CDonohoe-Designs/EdgeLink_S3_Cellular/docs/portfolio/EdgeLink_S3_Cellular/images/pcb-copper-bottom.png

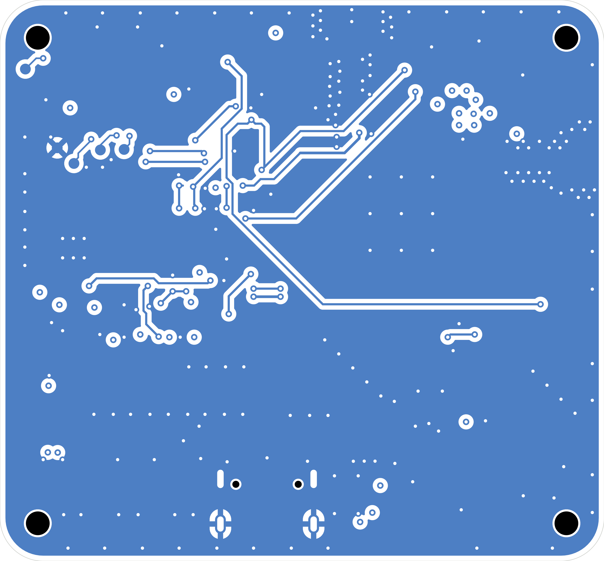
docs/portfolio/EdgeLink_S3_Cellular/images/pcb-copper-bottom.png
