CDonohoe-Designs/EdgeLink_S3_Cellular/docs/portfolio/EdgeLink_S3_Cellular/images/pcb-copper-inner-1.png

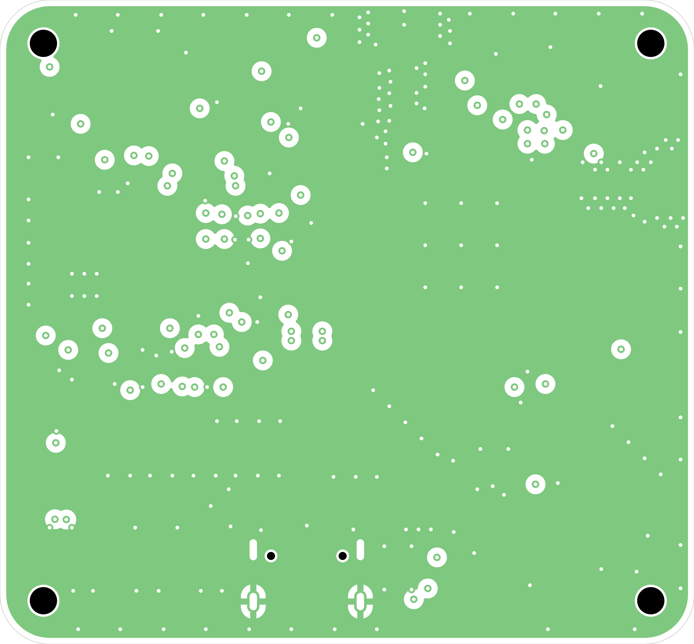
docs/portfolio/EdgeLink_S3_Cellular/images/pcb-copper-inner-1.png
