CDonohoe-Designs/EdgeLink_S3_Cellular/docs/portfolio/EdgeLink_S3_Cellular/images/pcb-stackup-evidence.png

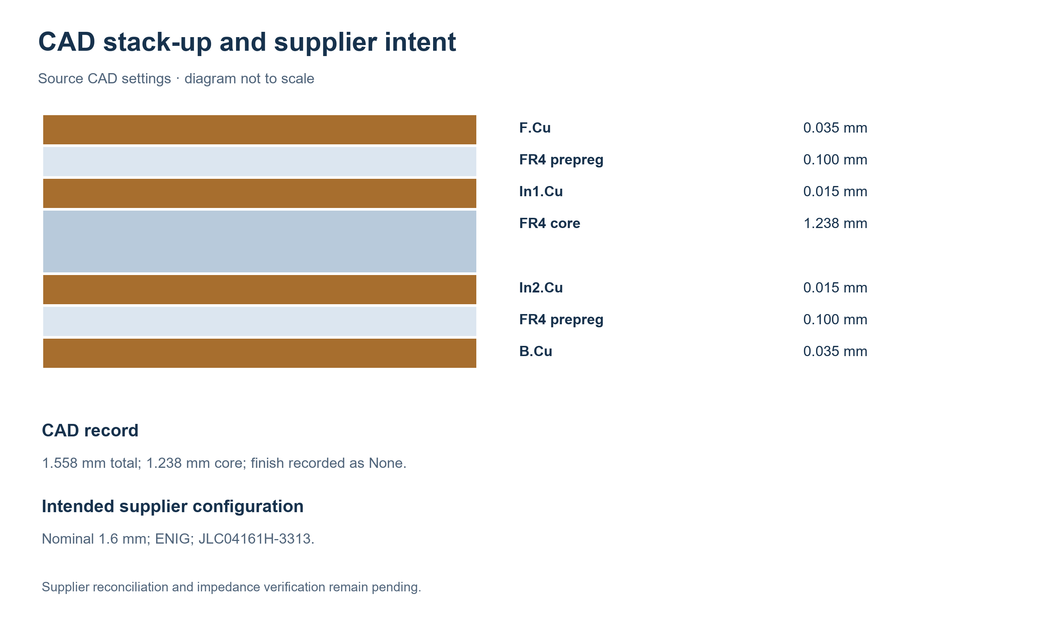
docs/portfolio/EdgeLink_S3_Cellular/images/pcb-stackup-evidence.png
