CDonohoe-Designs/EdgeLink_S3_Cellular/docs/portfolio/EdgeLink_S3_Cellular/images/proposed-six-page-layout.png

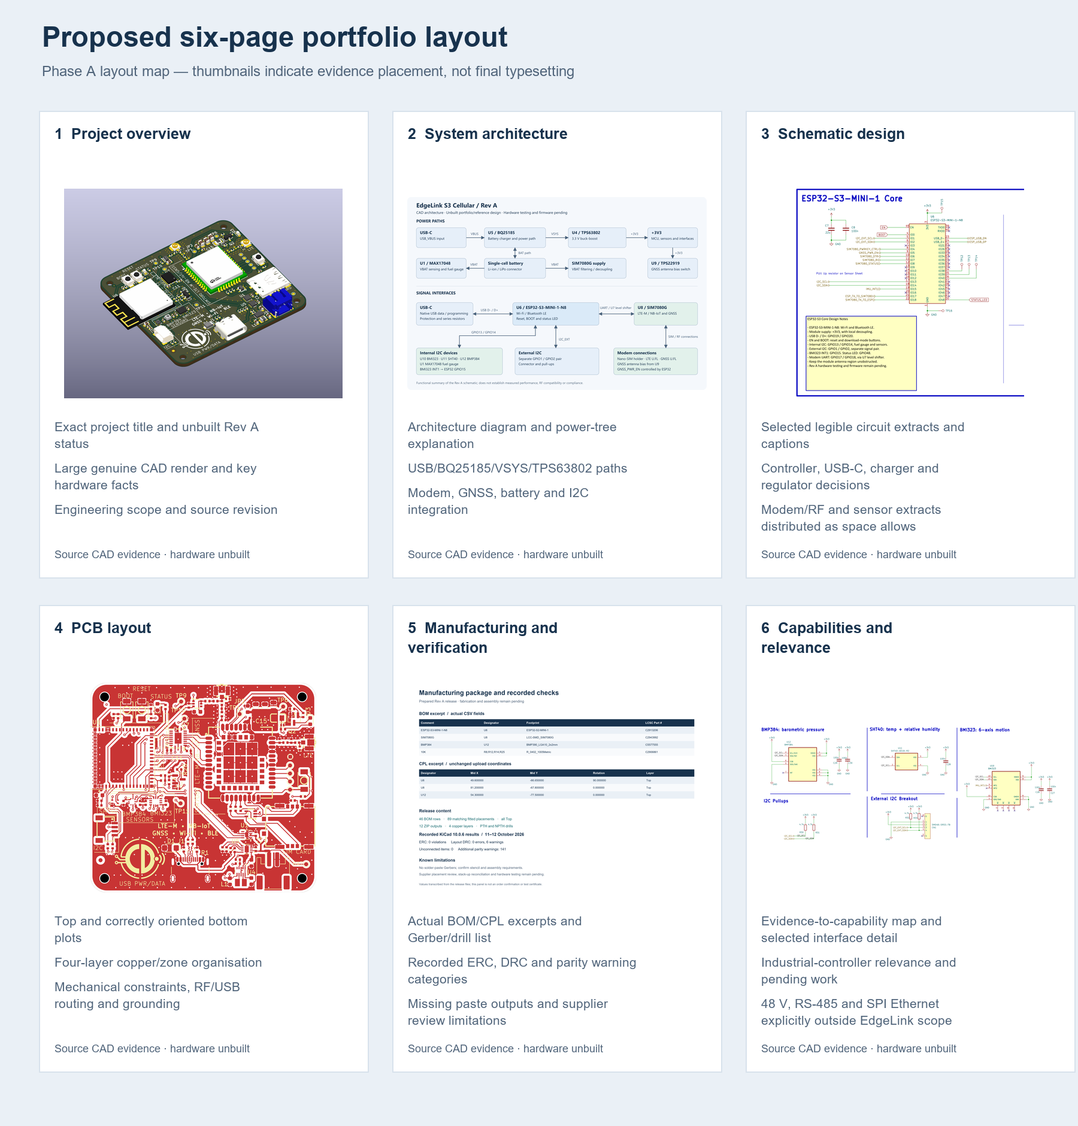
docs/portfolio/EdgeLink_S3_Cellular/images/proposed-six-page-layout.png
