CDonohoe-Designs/EdgeLink_S3_Cellular/docs/portfolio/EdgeLink_S3_Cellular/images/schematic-01_power_usb.png

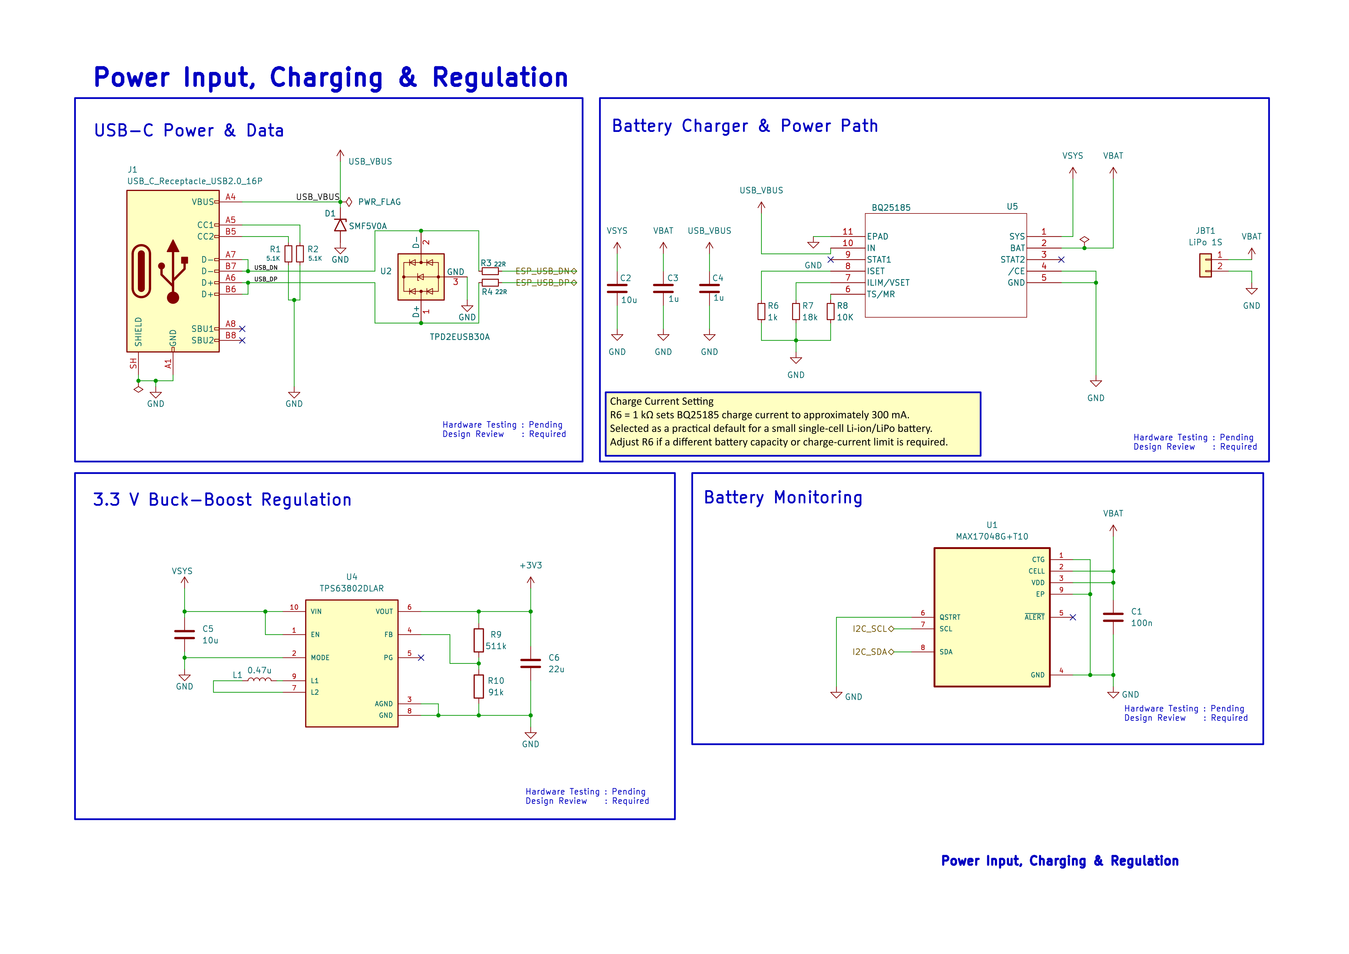
docs/portfolio/EdgeLink_S3_Cellular/images/schematic-01_power_usb.png
