CDonohoe-Designs/EdgeLink_S3_Cellular/docs/portfolio/EdgeLink_S3_Cellular/images/schematic-03_sim7080g_cellular_gnss.png

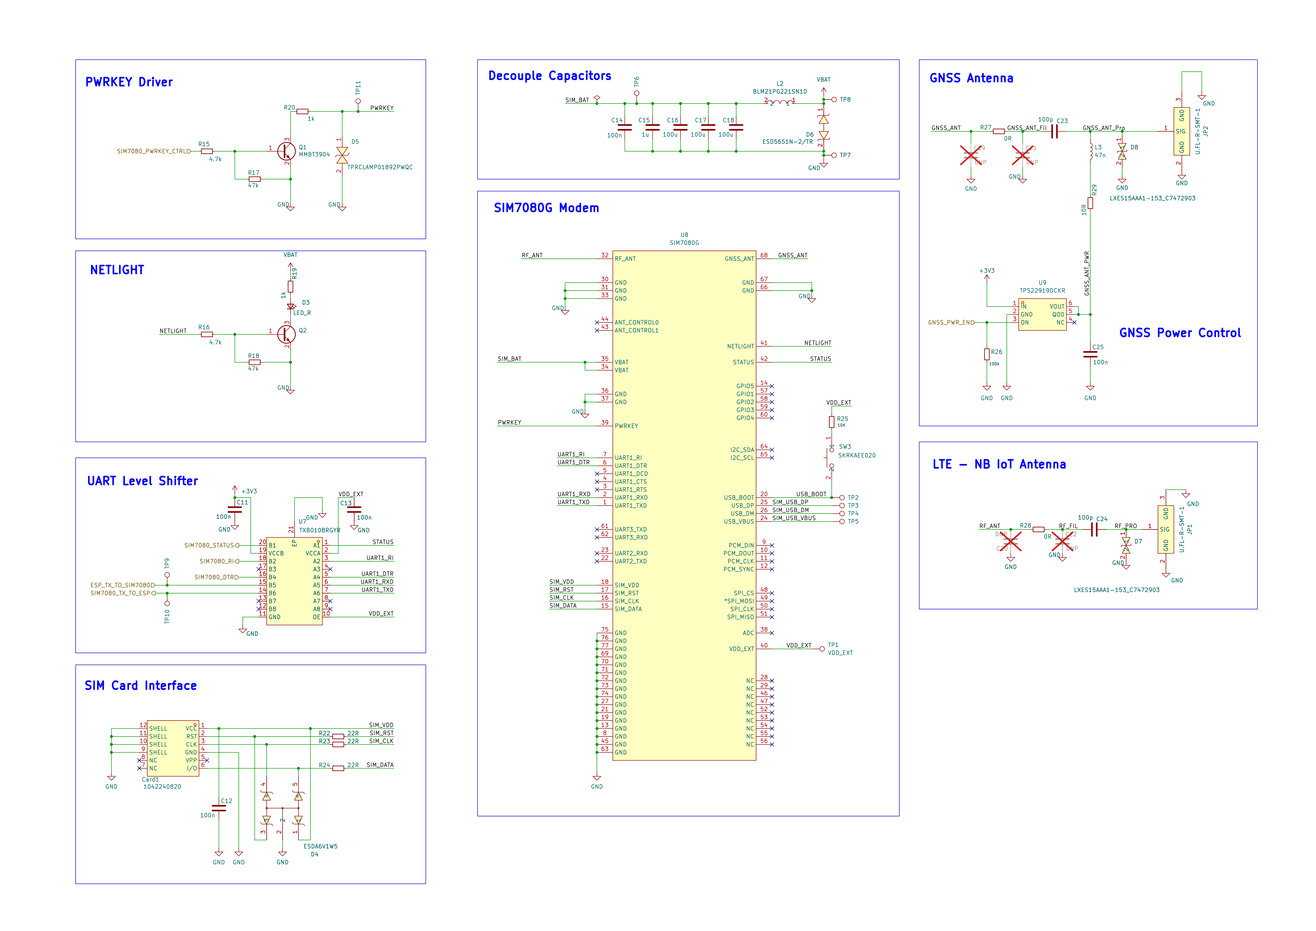
docs/portfolio/EdgeLink_S3_Cellular/images/schematic-03_sim7080g_cellular_gnss.png
