CDonohoe-Designs/EdgeLink_S3_Cellular/docs/portfolio/EdgeLink_S3_Cellular/images/schematic-04_sensors.png

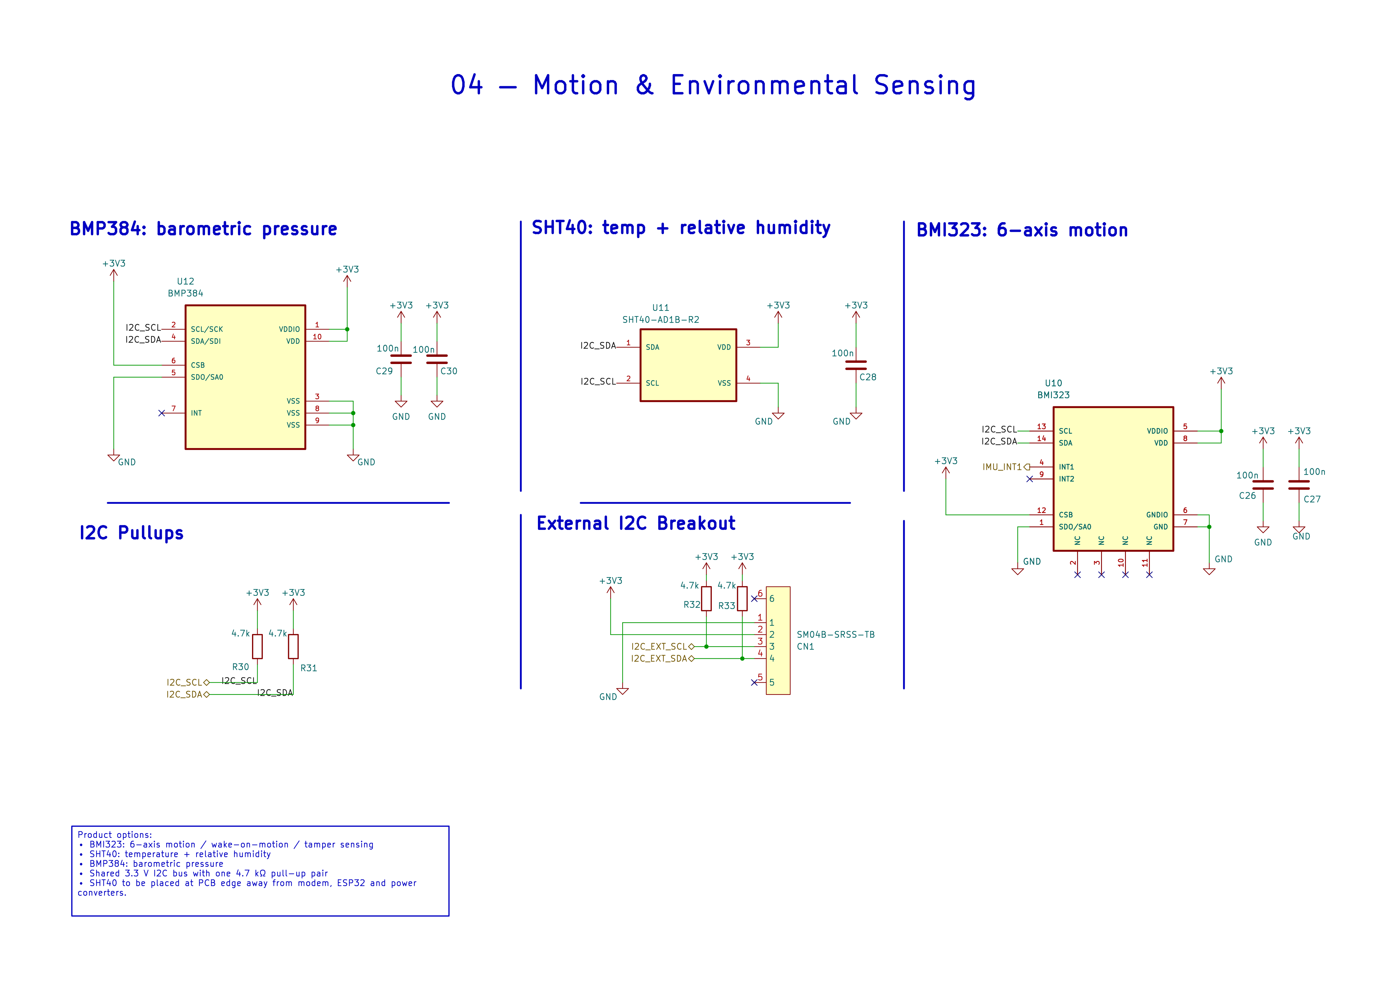
docs/portfolio/EdgeLink_S3_Cellular/images/schematic-04_sensors.png
