CDonohoe-Designs/EdgeLink_S3_Cellular/docs/portfolio/EdgeLink_S3_Cellular/images/schematic-bmi323.png

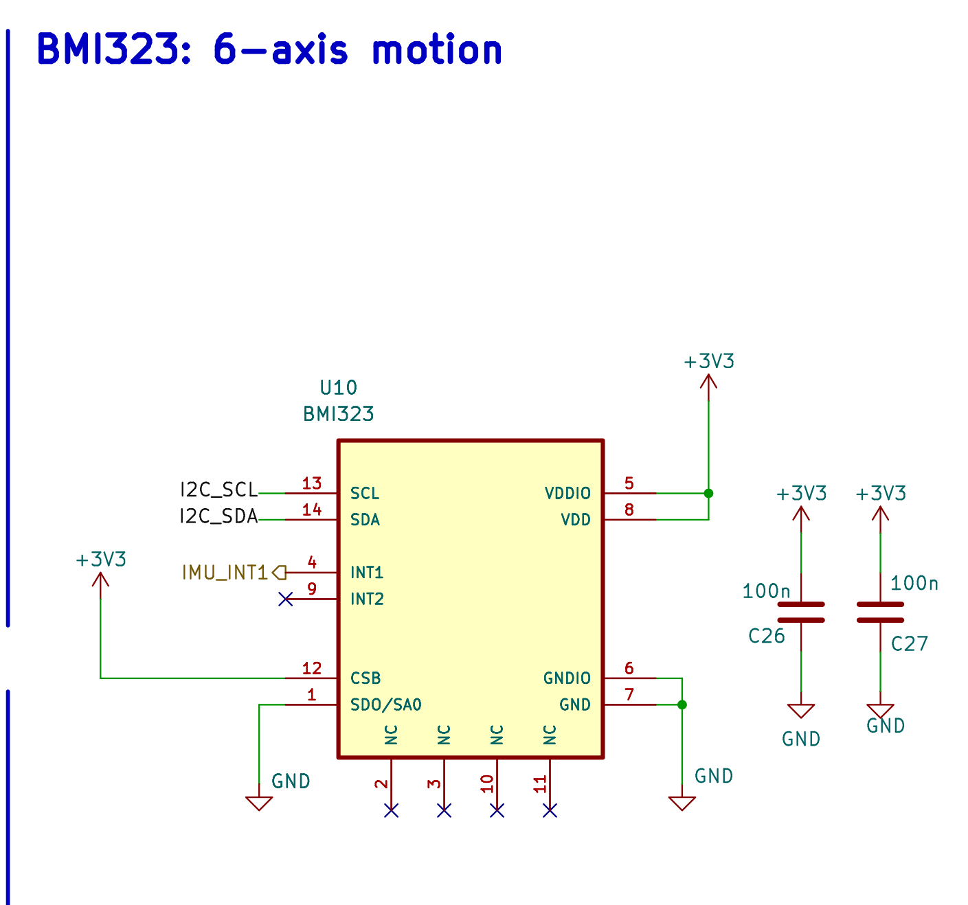
docs/portfolio/EdgeLink_S3_Cellular/images/schematic-bmi323.png
