CDonohoe-Designs/EdgeLink_S3_Cellular/docs/portfolio/EdgeLink_S3_Cellular/images/schematic-controller.png

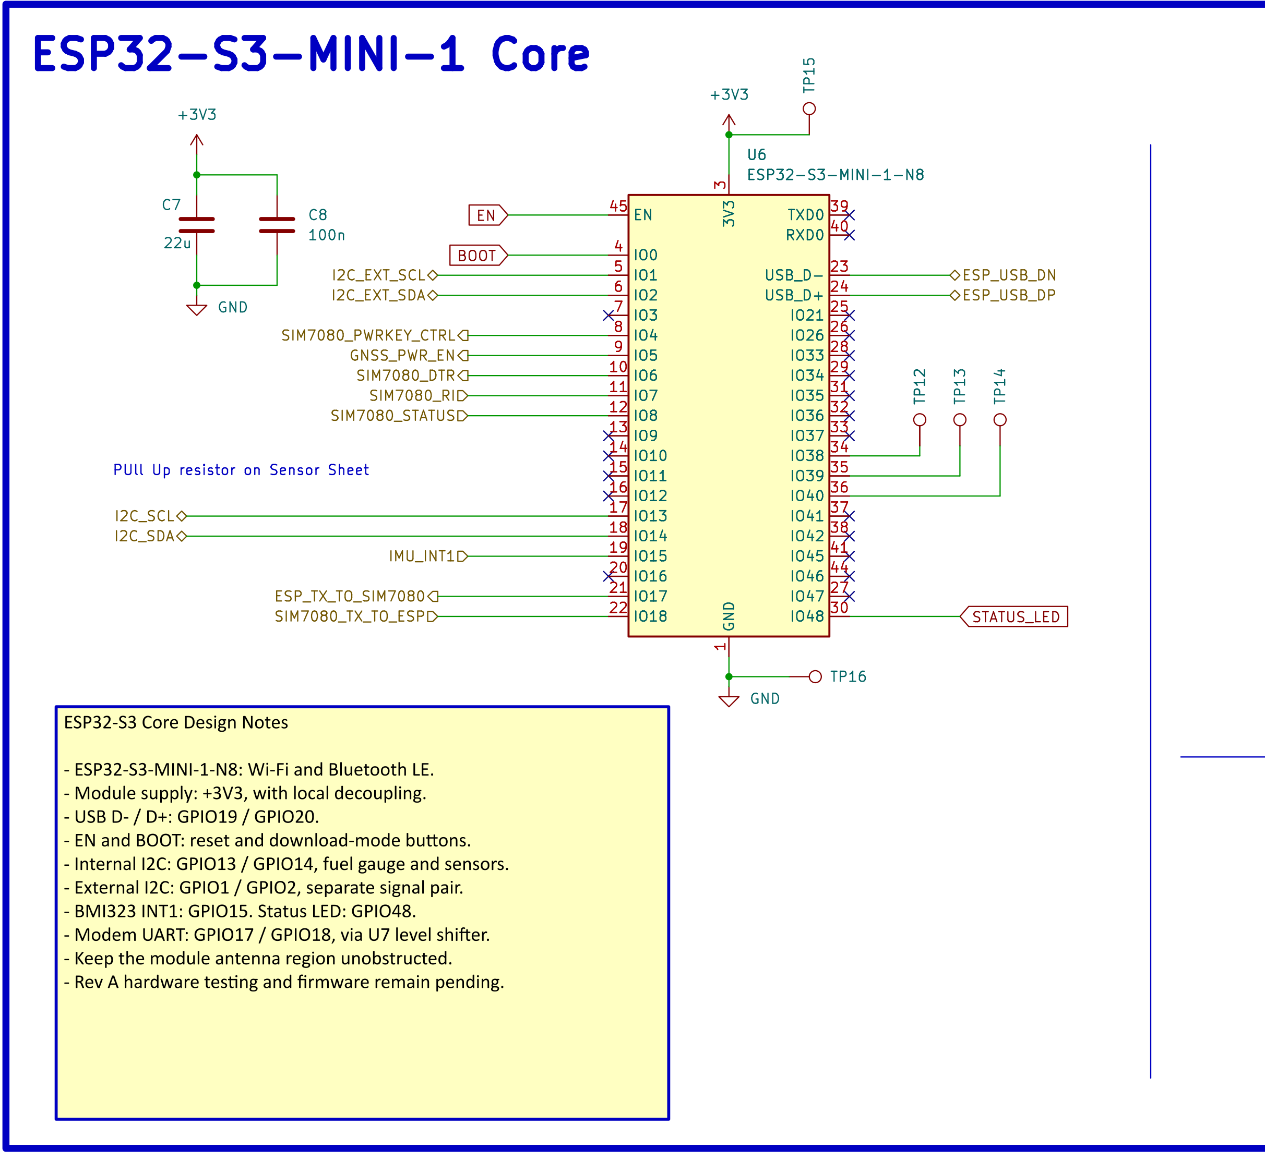
docs/portfolio/EdgeLink_S3_Cellular/images/schematic-controller.png
