CDonohoe-Designs/EdgeLink_S3_Cellular/docs/portfolio/EdgeLink_S3_Cellular/images/schematic-fuel-gauge.png

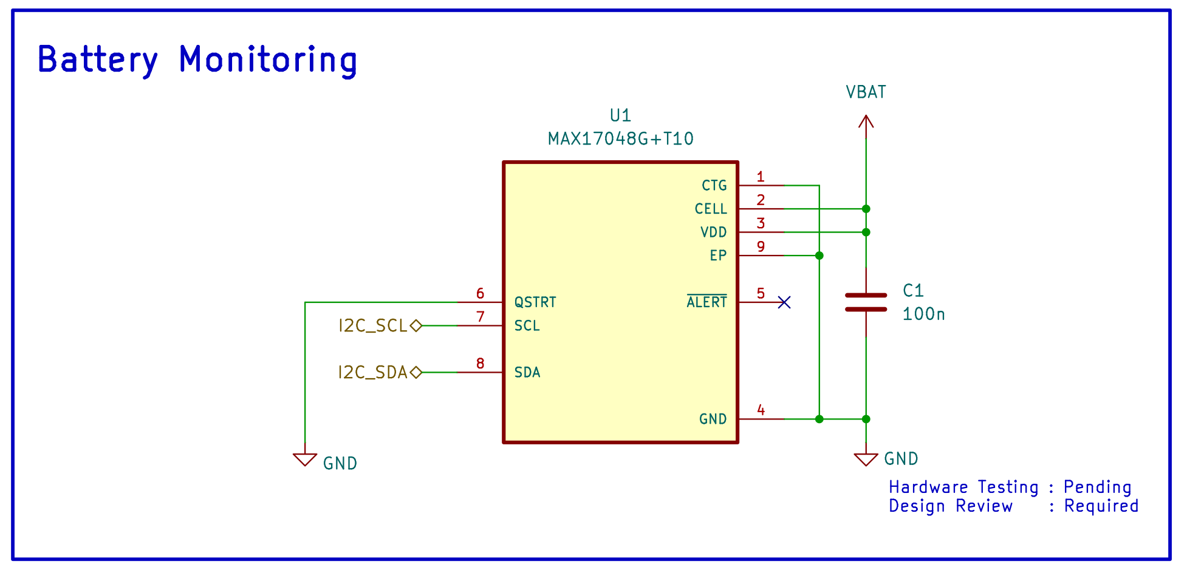
docs/portfolio/EdgeLink_S3_Cellular/images/schematic-fuel-gauge.png
