CDonohoe-Designs/EdgeLink_S3_Cellular/docs/portfolio/EdgeLink_S3_Cellular/images/schematic-gnss-antenna-power.png

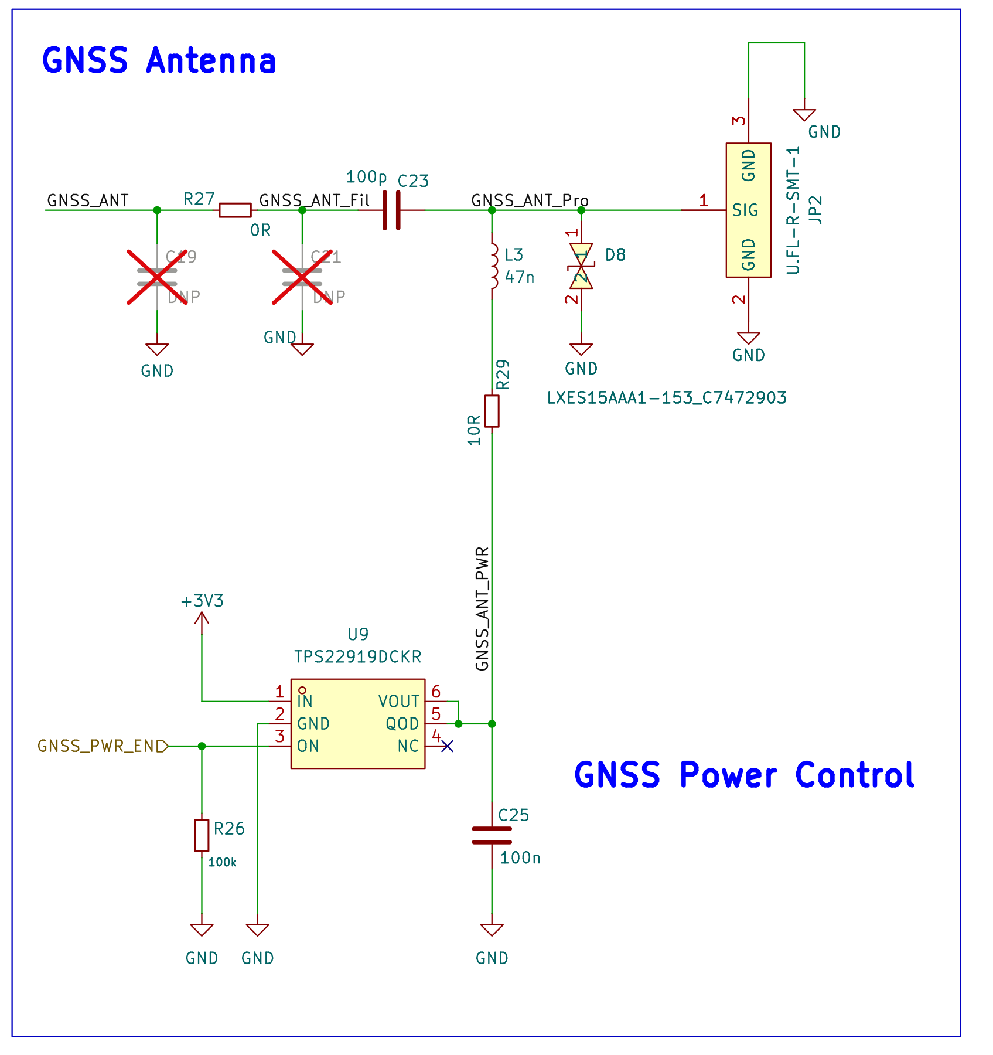
docs/portfolio/EdgeLink_S3_Cellular/images/schematic-gnss-antenna-power.png
