CDonohoe-Designs/EdgeLink_S3_Cellular/docs/portfolio/EdgeLink_S3_Cellular/images/schematic-lte-rf-interface.png

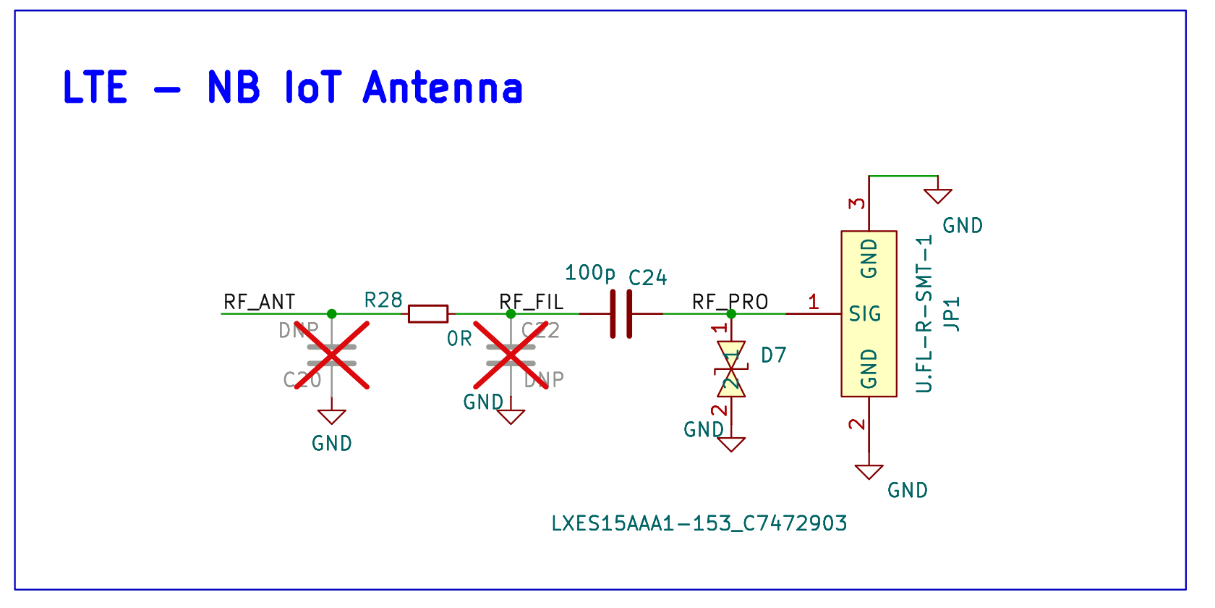
docs/portfolio/EdgeLink_S3_Cellular/images/schematic-lte-rf-interface.png
