CDonohoe-Designs/EdgeLink_S3_Cellular/docs/portfolio/EdgeLink_S3_Cellular/images/schematic-modem-uart-level-shifter.png

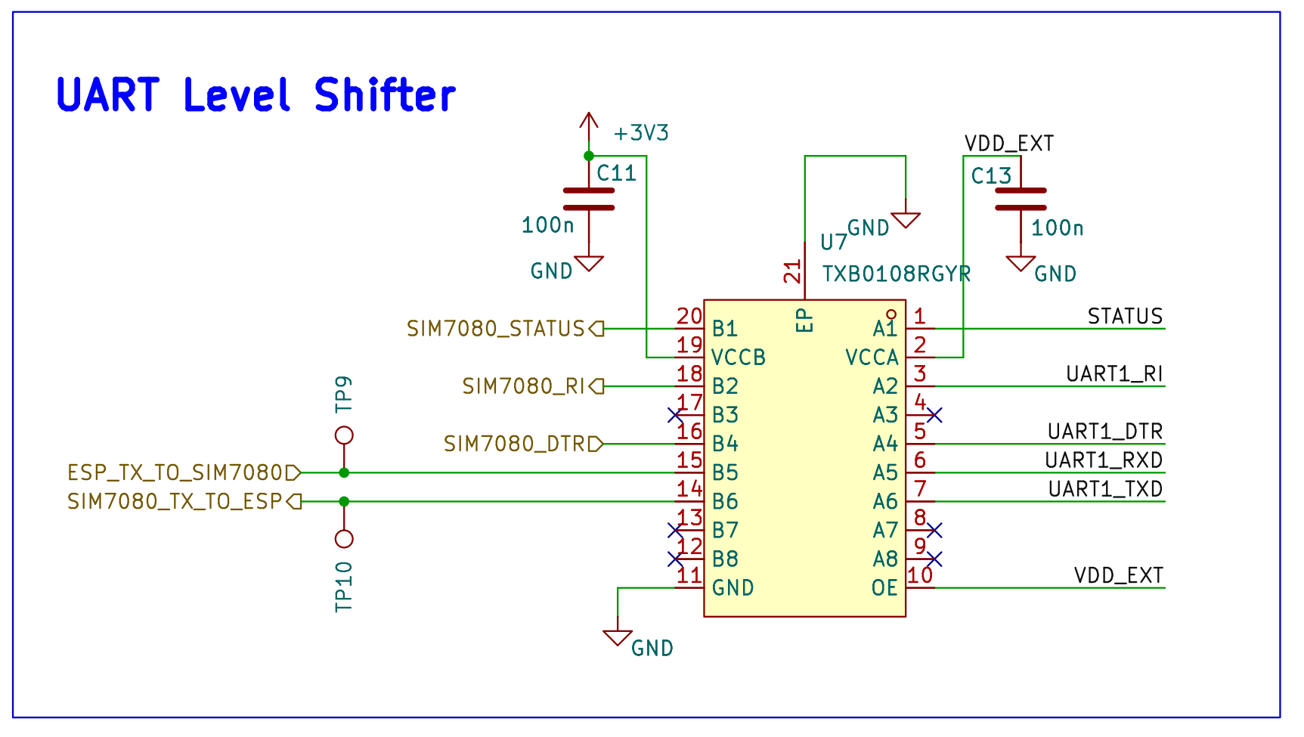
docs/portfolio/EdgeLink_S3_Cellular/images/schematic-modem-uart-level-shifter.png
