CDonohoe-Designs/EdgeLink_S3_Cellular/docs/portfolio/EdgeLink_S3_Cellular/images/schematic-nano-sim.png

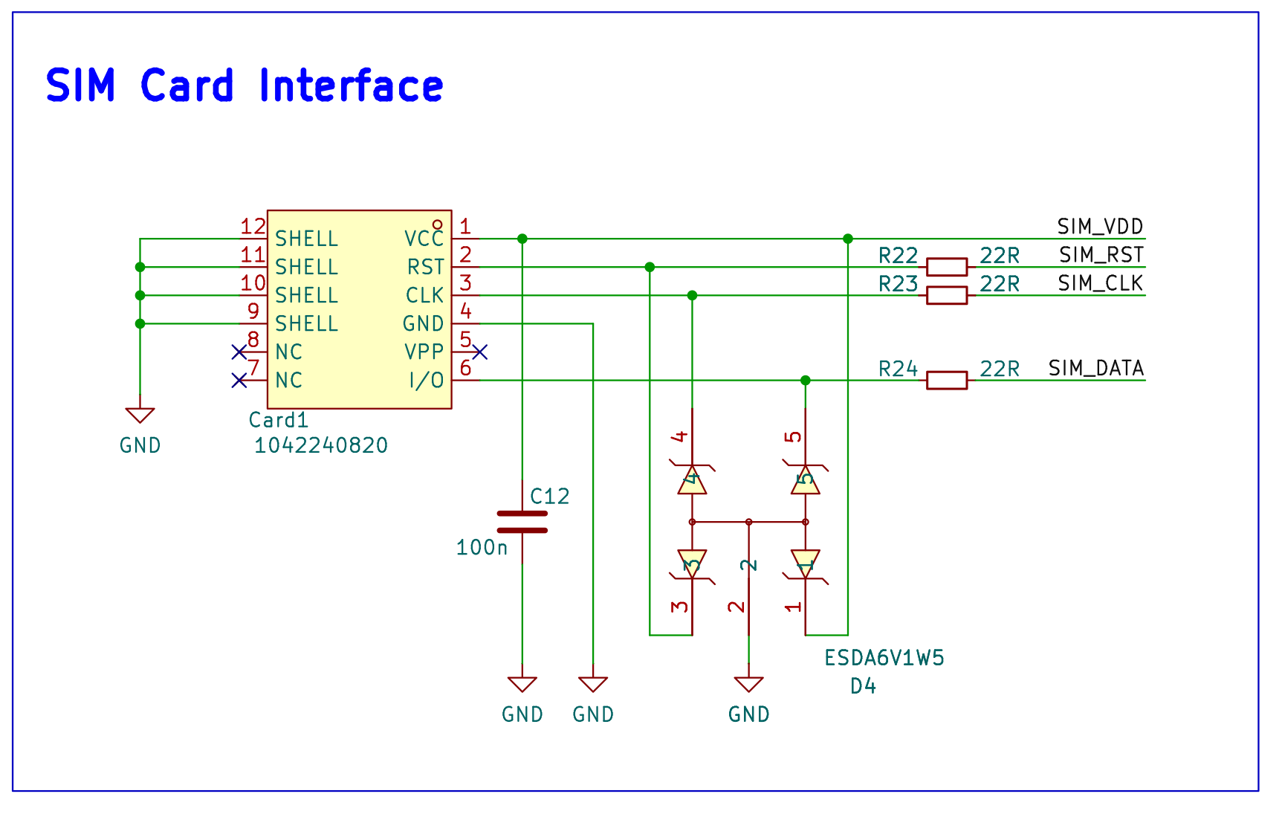
docs/portfolio/EdgeLink_S3_Cellular/images/schematic-nano-sim.png
