CDonohoe-Designs/EdgeLink_S3_Cellular/docs/portfolio/EdgeLink_S3_Cellular/images/schematic-sensors-i2c.png

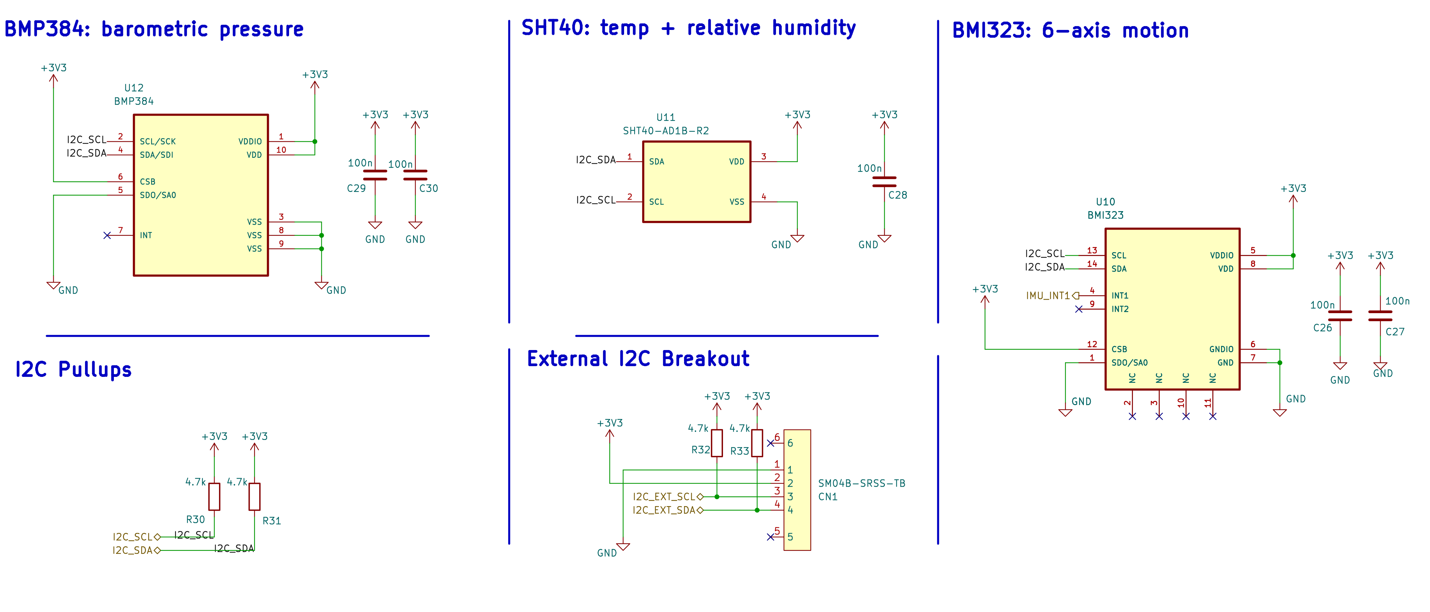
docs/portfolio/EdgeLink_S3_Cellular/images/schematic-sensors-i2c.png
