CDonohoe-Designs/EdgeLink_S3_Cellular/docs/portfolio/EdgeLink_S3_Cellular/images/schematic-sim7080g-interface.png

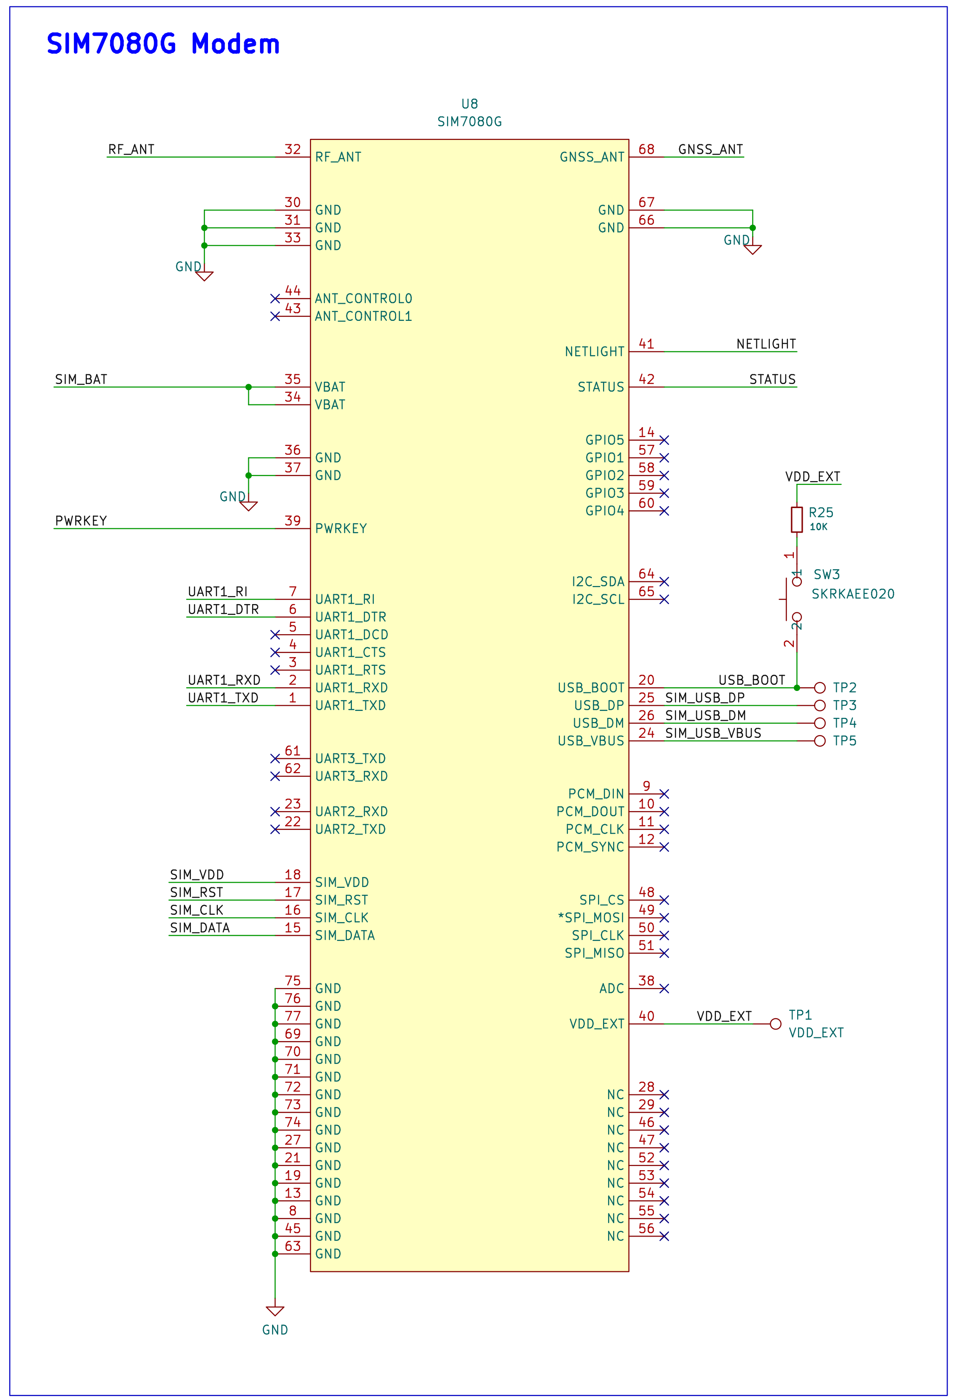
docs/portfolio/EdgeLink_S3_Cellular/images/schematic-sim7080g-interface.png
