CDonohoe-Designs/EdgeLink_S3_Cellular/docs/portfolio/EdgeLink_S3_Cellular/images/schematic-tps63802-regulator.png

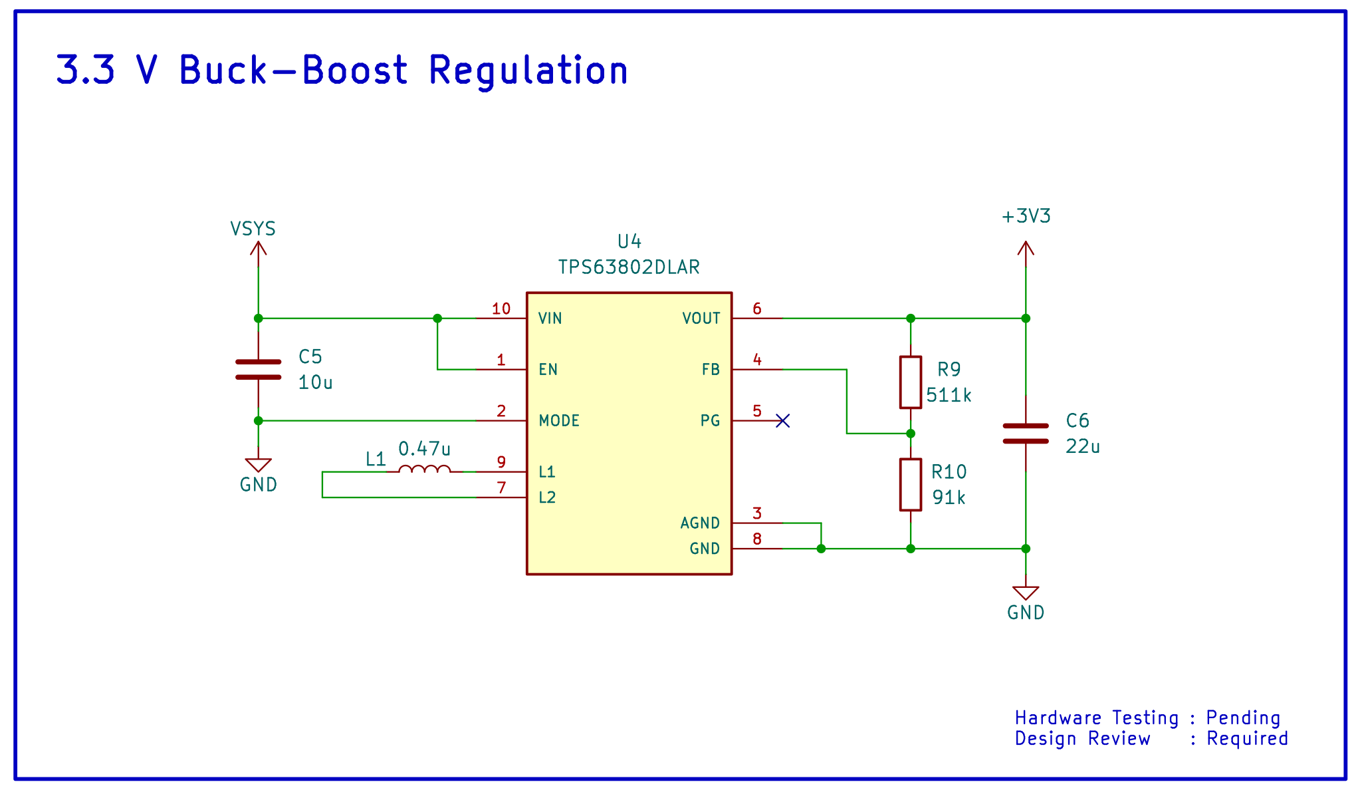
docs/portfolio/EdgeLink_S3_Cellular/images/schematic-tps63802-regulator.png
