CDonohoe-Designs/EdgeLink_S3_Cellular/manufacturing/REV_A/bom/EdgeLink_S3_Cellular_RevA_BOM_JLCPCB.csv

Reference | Qty | Value | Footprint | Manufacturer | MPN | LCSC Part | DNP | Datasheet
D1 | 1 | SMF5V0A | Diode_SMD:D_SMF | VISHAY | SMF5V0A-E3-08 | C1972946 |  | https://www.vishay.com/doc?85881
J1 | 1 | USB_C_Receptacle_USB2.0_16P | Connector_USB:USB_C_Receptacle_GCT_USB4105-xx-A_16P_TopMnt_Horizontal | Global Connector Technology | USB4105-GF-A | C3020560 |  | https://www.usb.org/sites/default/files/documents/usb_type-c.zip
U5 | 1 | BQ25185 | BQ25185:WSON10_DLH_TEX | TI | BQ25185DLHR | C19725033 |  | https://www.ti.com/lit/gpn/bq25185
Q1,Q2 | 2 | MMBT3904 | Package_TO_SOT_SMD:SOT-23 | R+O | MMBT3904 | C7420353 |  | https://www.onsemi.com/pdf/datasheet/pzt3904-d.pdf
D5 | 1 | TPRCLAMP01892PWQC | TPRCLAMP01892PWQC:DFN1006-2L-BI-1 | TECH PUBLIC | TPRCLAMP01892PWQC | C52098254 |  | https://www.lcsc.com/datasheet/C52098254.pdf
D7,D8 | 2 | LXES15AAA1-153_C7472903 | LXES15AAA1-153:DFN1006-2L-BI | TECH PUBLIC | LXES15AAA1-153 | C7472903 |  | https://www.lcsc.com/datasheet/C7472903.pdf
U8 | 1 | SIM7080G | SIM7080G:LCC-SMD_SIM7080G | SIMCom Wireless Solutions | SIM7080G | C2943992 |  | https://www.lcsc.com/datasheet/C2943992.pdf
U9 | 1 | TPS22919DCKR | TPS22919DCKR:SC-70-6_L2.2-W1.3-P0.65-LS2.1-BR | TI | TPS22919DCKR | C2149796 |  | https://www.lcsc.com/datasheet/C2149796.pdf
Card1 | 1 | 1042240820 | 1042240820:SIM-SMD_1042240820 | MOLEX | 1042240820 | C585349 |  | https://www.lcsc.com/datasheet/C585349.pdf
U6 | 1 | ESP32-S3-MINI-1-N8 | RF_Module:ESP32-S2-MINI-1 | ESPRESSIF | ESP32-S3-MINI-1-N8 | C2913206 |  | https://www.espressif.com/sites/default/files/documentation/esp32-s3-mini-1_mini-1u_datasheet_en.pdf
U12 | 1 | BMP384 | Sensor_Footprints:BMP390_LGA10_2x2mm | Bosch Sensortec | BMP384 | C5577555 |  | https://www.bosch-sensortec.com/media/boschsensortec/downloads/datasheets/bst-bmp384-ds003.pdf
U10 | 1 | BMI323 | Package_LGA:Bosch_LGA-14_3x2.5mm_P0.5mm | Bosch | BMI323 | C5368700 |  | https://www.bosch-sensortec.com/media/boschsensortec/downloads/datasheets/bst-bmi323-ds000.PDF
U11 | 1 | SHT40-AD1B-R2 | Sensor_Footprints:SHT4x_DFN4_1.5x1.5mm | Sensirion | SHT40-AD1B-R2 | C2909890 |  | https://sensirion.com/media/documents/33FD6951/6555C40E/Sensirion_Datasheet_SHT4x.pdf
D2,D3 | 2 | LED_R | LED_SMD:LED_0603_1608Metric | LITEON | LTST-C193KRKT-5A | C157741 |  | https://optoelectronics.liteon.com/upload/download/DS22-2005-077/LTST-C193KRKT-5A.PDF
SW1,SW2,SW3 | 3 | SKRKAEE020 | SKRKAEE020:SW-SMD_L3.9-W3.0-P4.45 | ALPSALPINE | SKRKAEE020 | C115357 |  | https://lcsc.com/product-detail/Tactile-Switches_ALPS_SKRKAEE020_3-4-2-1-57N_C115357.html
D6 | 1 | ESD5651N-2/TR | ESD5651N-2:DFN1006-2L-BI-1 | WILLSEMI | ESD5651N-2/TR | C239784 |  | https://lcsc.com/product-detail/Others_Will-Semicon-ESD5651N-2-TR_C239784.html
CN1 | 1 | SM04B-SRSS-TB | SM04B-SRSS-TB:CONN-SMD_4P-P1.00_SM04B-SRSS-TB-LF-SN | JST | SM04B-SRSS-TB(LF)(SN) | C160404 |  | https://lcsc.com/product-detail/Others_JST-Sales-America__JST-Sales-America-SM04B-SRSS-TB-LF-SN_C160404.html
L2 | 1 | BLM21PG221SN1D | BLM21PG221SN1D:L0805 | muRata | BLM21PG221SN1D | C85840 |  | https://lcsc.com/product-detail/Ferrite-Beads-And-Chips_muRata_BLM21PG221SN1D_220R-25-at100MHz-2A_C85840.html
D4 | 1 | ESDA6V1W5 | ESDA6V1W5:SC-70-5_L2.1-W1.3-P0.65-LS2.1-BR | ST | ESDA6V1W5 | C48677 |  | https://lcsc.com/product-detail/Diodes-ESD_STMicroelectronics_ESDA6V1W5_ESDA6V1W5_C48677.html
JP1,JP2 | 2 | U.FL-R-SMT-1 | U:RF-SMD_FRF05002-JSS103M | HRS | U.FL-R-SMT-1(80) | C88374 |  | https://lcsc.com/product-detail/Connectors_HRS_U-FL-R-SMT-1-80_3310472280-IPE-XBoard-end-IPXConnector-SMD_C88374.html
U7 | 1 | TXB0108RGYR | TXB0108RGYR:VQFN-20_L4.5-W3.5-P0.50-BL-EP | TI | TXB0108RGYR | C194701 |  | https://lcsc.com/product-detail/_Texas-Instruments_TXB0108RGYR_Texas-Instruments-Texas-Instruments-TXB0108RGYR_C194701.html
U2 | 1 | TPD2EUSB30A | Package_TO_SOT_SMD:Texas_DRT-3 | TI | TPD2EUSB30ADRTR | C94934 |  | http://www.ti.com/lit/ds/symlink/tpd2eusb30a.pdf
U4 | 1 | TPS63802DLAR | TPS63802:TPS63802DLAR | TI | TPS63802DLAR | C2845237
U1 | 1 | MAX17048G+T10 | Package_DFN_QFN:TDFN-8-1EP_2x2mm_P0.5mm_EP0.8x1.2mm | MAXIM | MAX17048G+T10 | C2682616
R29 | 1 | 10R | Resistor_SMD:R_0402_1005Metric | FOJAN | FRC0402F10R0TS | C2906862
R27,R28 | 2 | 0R | Resistor_SMD:R_0402_1005Metric | UNI-ROYAL | CQ02WGF0000TCE | C2770621
R26 | 1 | 100k | Resistor_SMD:R_0402_1005Metric | FOJAN | FRC0402F1003TS | C2906859
R17,R18 | 2 | 47k | Resistor_SMD:R_0402_1005Metric | UNI-ROYAL | 0402WGF4702TCE | C25792
R15,R16,R30,R31,R32,R33 | 6 | 4.7k | Resistor_SMD:R_0402_1005Metric | UNI-ROYAL | 0402WGF4701TCE | C25900
R10 | 1 | 91k | Resistor_SMD:R_0402_1005Metric | FOJAN | FRC0402F9102TS | C2909393
R9 | 1 | 511k | Resistor_SMD:R_0402_1005Metric | FOJAN | FRC0402F5113TS | C5126239
R8,R12,R14,R25 | 4 | 10K | Resistor_SMD:R_0402_1005Metric | FOJAN | FRC0402F1002TS | C2906861
R7 | 1 | 18k | Resistor_SMD:R_0402_1005Metric | FOJAN | FRC0402F1802TS | C2909327
R6,R13,R19,R20 | 4 | 1k | Resistor_SMD:R_0402_1005Metric | FOJAN | FRC0402F1001TS | C2906864
R3,R4,R22,R23,R24 | 5 | 22R | Resistor_SMD:R_0402_1005Metric | FOJAN | FRC0402F22R0TS | C2929994
R1,R2 | 2 | 5.1K | Resistor_SMD:R_0402_1005Metric | FOJAN | FRC0402F5101TS | C2906874
L3 | 1 | 47n | Inductor_SMD:L_0402_1005Metric | Coilcraft | 0402DC-47NXJRW | C3221702
L1 | 1 | 0.47u | DFE201612E-R47M_P2:INDC2016X120N | muRata | DFE201612E-R47M=P2 | C668312
JBT1 | 1 | LiPo 1S | Connector_JST:JST_PH_S2B-PH-SM4-TB_1x02-1MP_P2.00mm_Horizontal | JST | S2B-PH-SM4-TB(LF)(SN) | C295747
C23,C24 | 2 | 100p | Capacitor_SMD:C_0402_1005Metric | Murata | GCM1555C1H101JA16D | C126492
C16,C17,C18 | 3 | 100u | Capacitor_SMD:C_0805_2012Metric | muRata | GRM21BR60J107ME15L | C141660
C14,C25 | 2 | 100n | Capacitor_SMD:C_0603_1608Metric | YAGEO | CC0603KRX7R9BB104 | C14663
C6,C7 | 2 | 22u | Capacitor_SMD:C_0603_1608Metric | Samsung Electro-Mechanics | CL10A226MO7JZNC | C2762594
C3,C4,C15 | 3 | 1u | Capacitor_SMD:C_0402_1005Metric | Samsung Electro-Mechanics | CL05A105KA5NQNC | C52923
C2,C5 | 2 | 10u | Capacitor_SMD:C_0603_1608Metric | Murata Electronics | GRM188R61E106MA73D | C91606
C1,C8,C9,C10,C11,C12,C13,C26,C27,C28,C29,C30 | 12 | 100n | Capacitor_SMD:C_0402_1005Metric | Samsung Electro-Mechanics | CL05B104KB54PNC | C307331
