CDonohoe-Designs/EdgeLink_S3_Cellular/hardware/kicad/EdgeLink_S3_Cellular_RevA/3D_Models/JST/JST-S2B-PH-SM4-TB.STEP

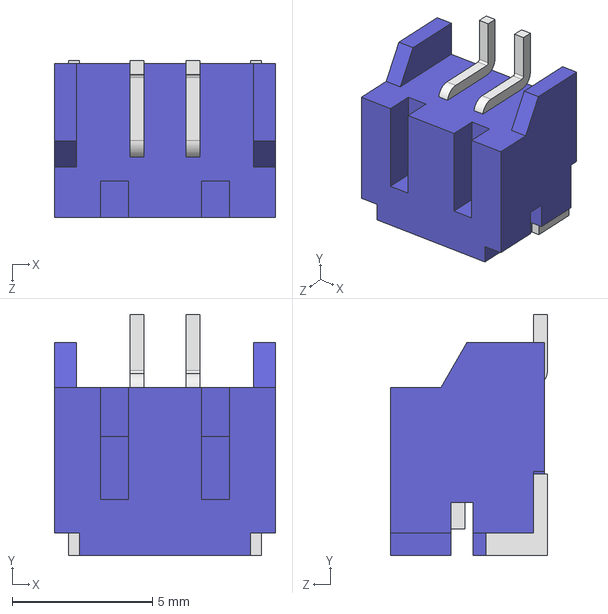
[picture p41: CAD file, 2026-10-12]
hardware/kicad/EdgeLink_S3_Cellular_RevA/3D_Models/JST/JST-S2B-PH-SM4-TB.STEP
7.90 x 8.60 x 5.60 mm
