CDonohoe-Designs/EdgeLink_S3_Cellular/docs/portfolio/EdgeLink_S3_Cellular/images/manufacturing-and-verification-evidence.png

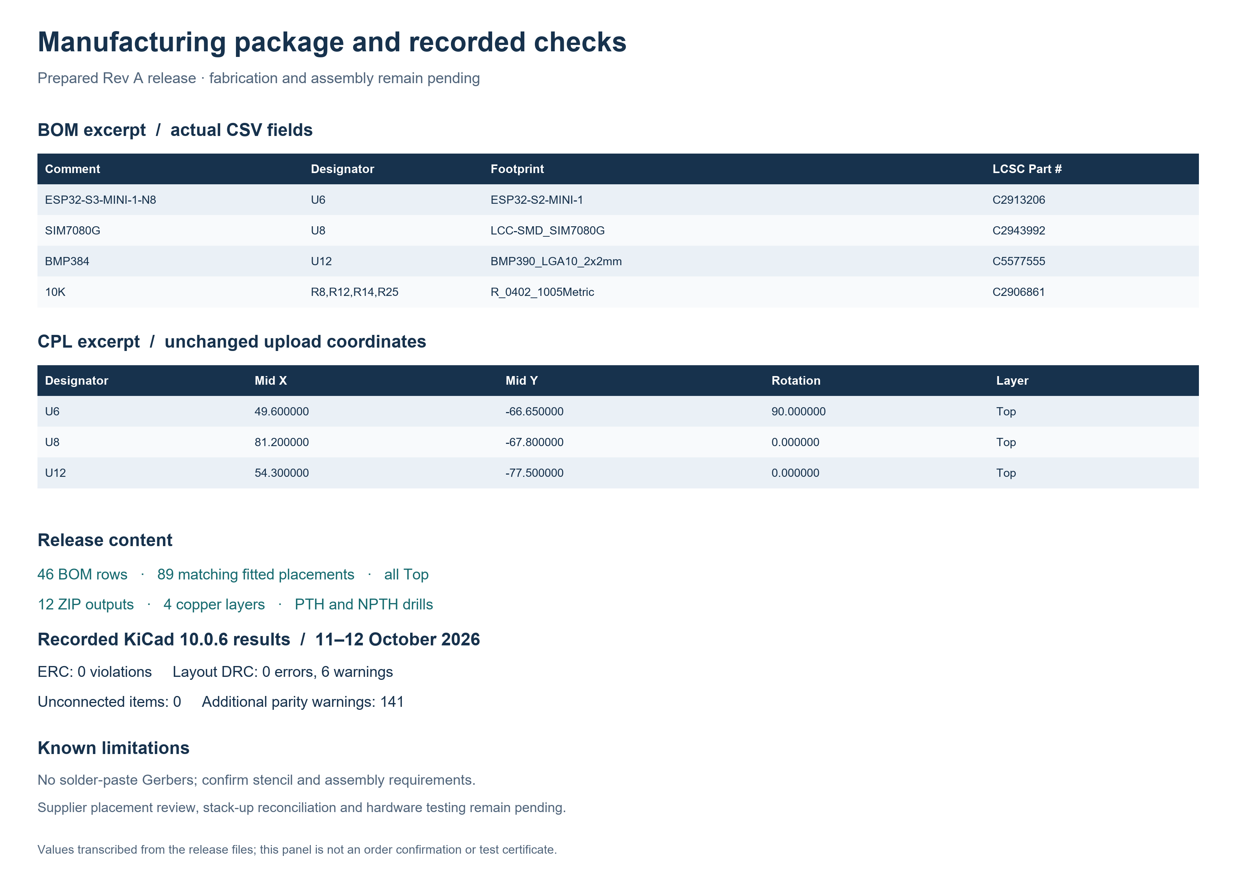
docs/portfolio/EdgeLink_S3_Cellular/images/manufacturing-and-verification-evidence.png
