CDonohoe-Designs/EdgeLink_S3_Cellular/docs/schematics/EdgeLink_S3_Cellular_RevA_Schematic.pdf

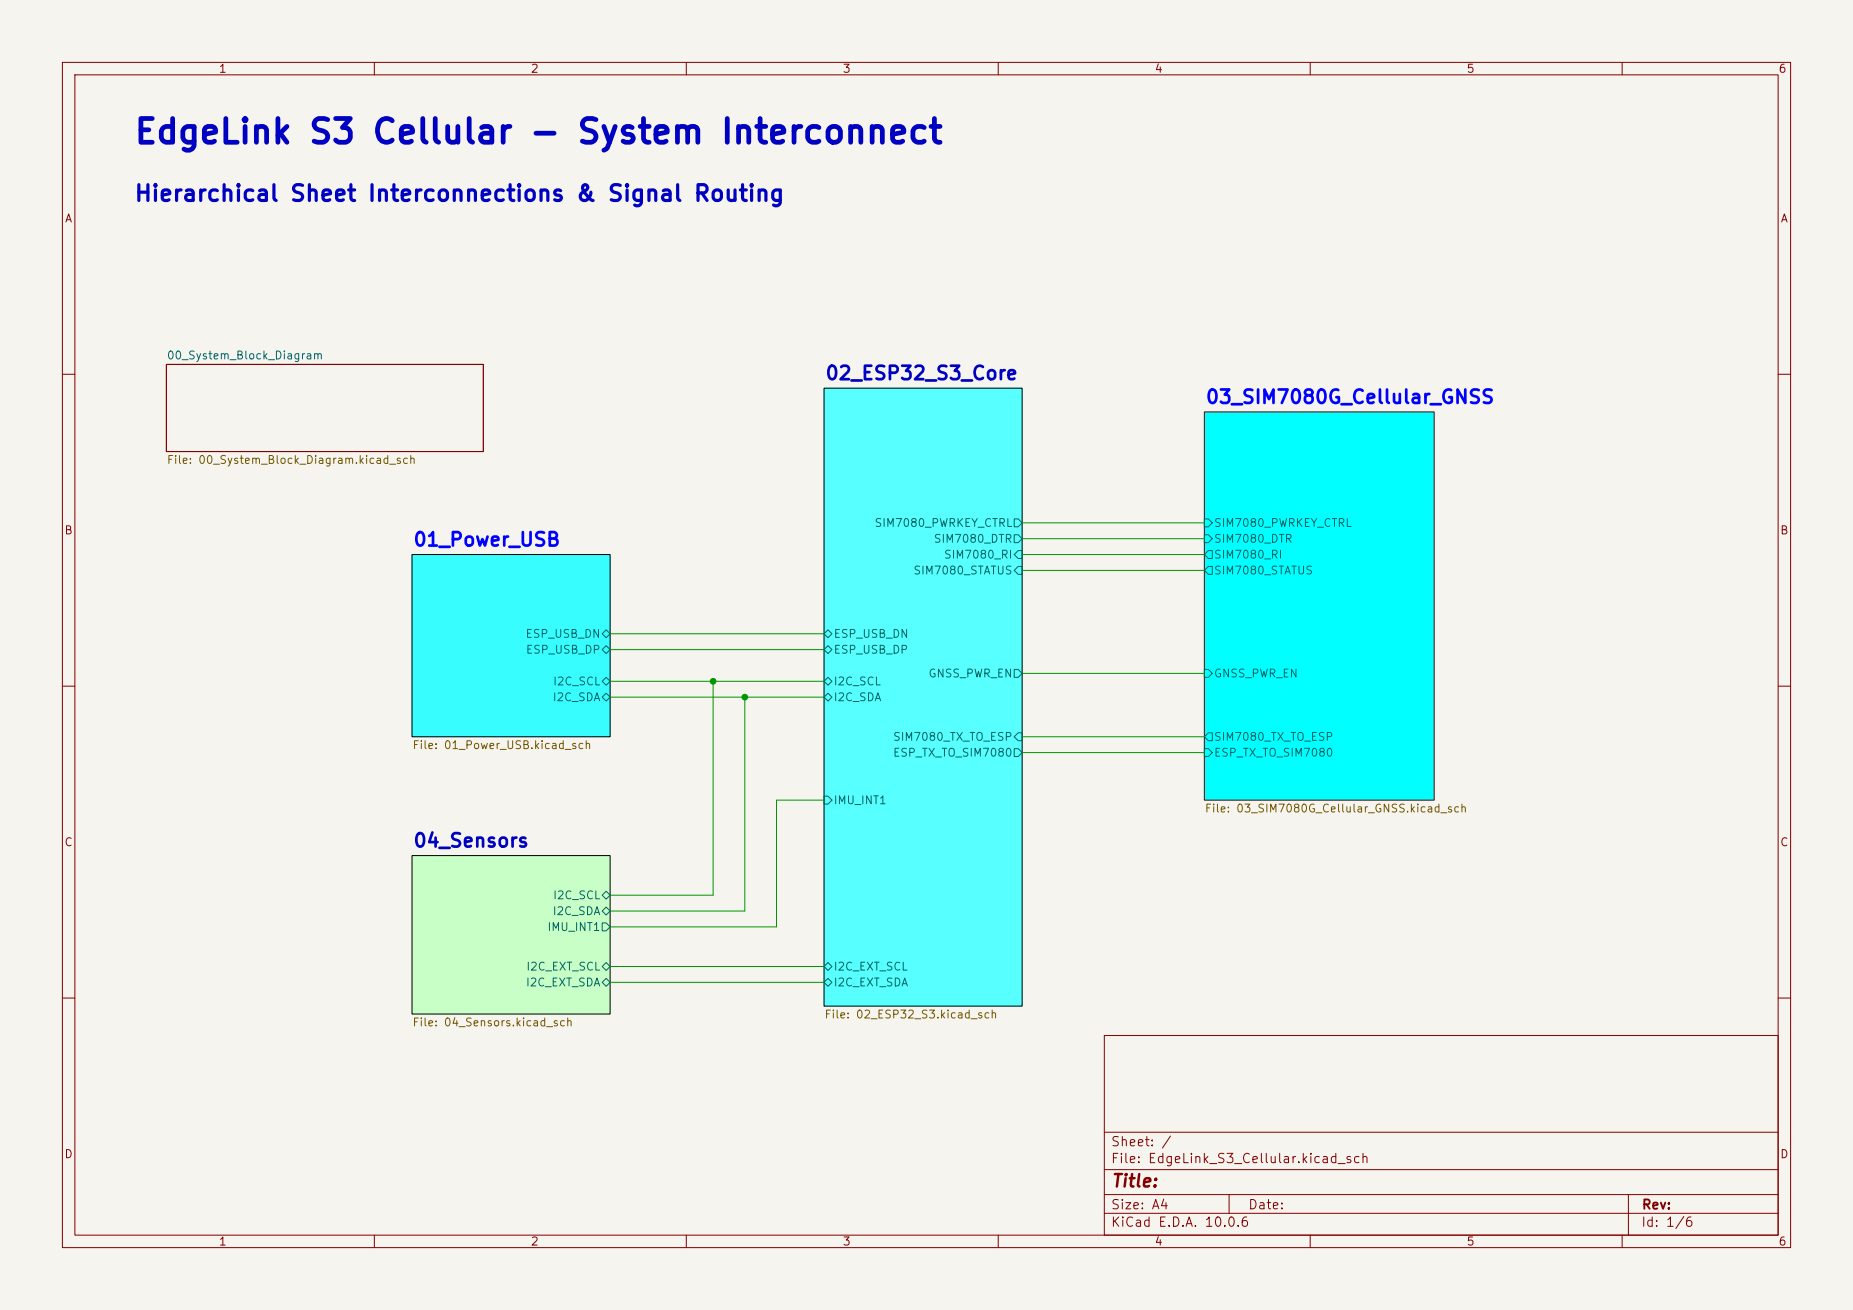
[picture p43: page 1]

EdgeLink S3 Cellular - System Interconnect

Hierarchical Sheet Interconnections & Signal Routing

Size: A4 | Rev:
KiCad E.D.A. 10.0.6 | Id: 1/6

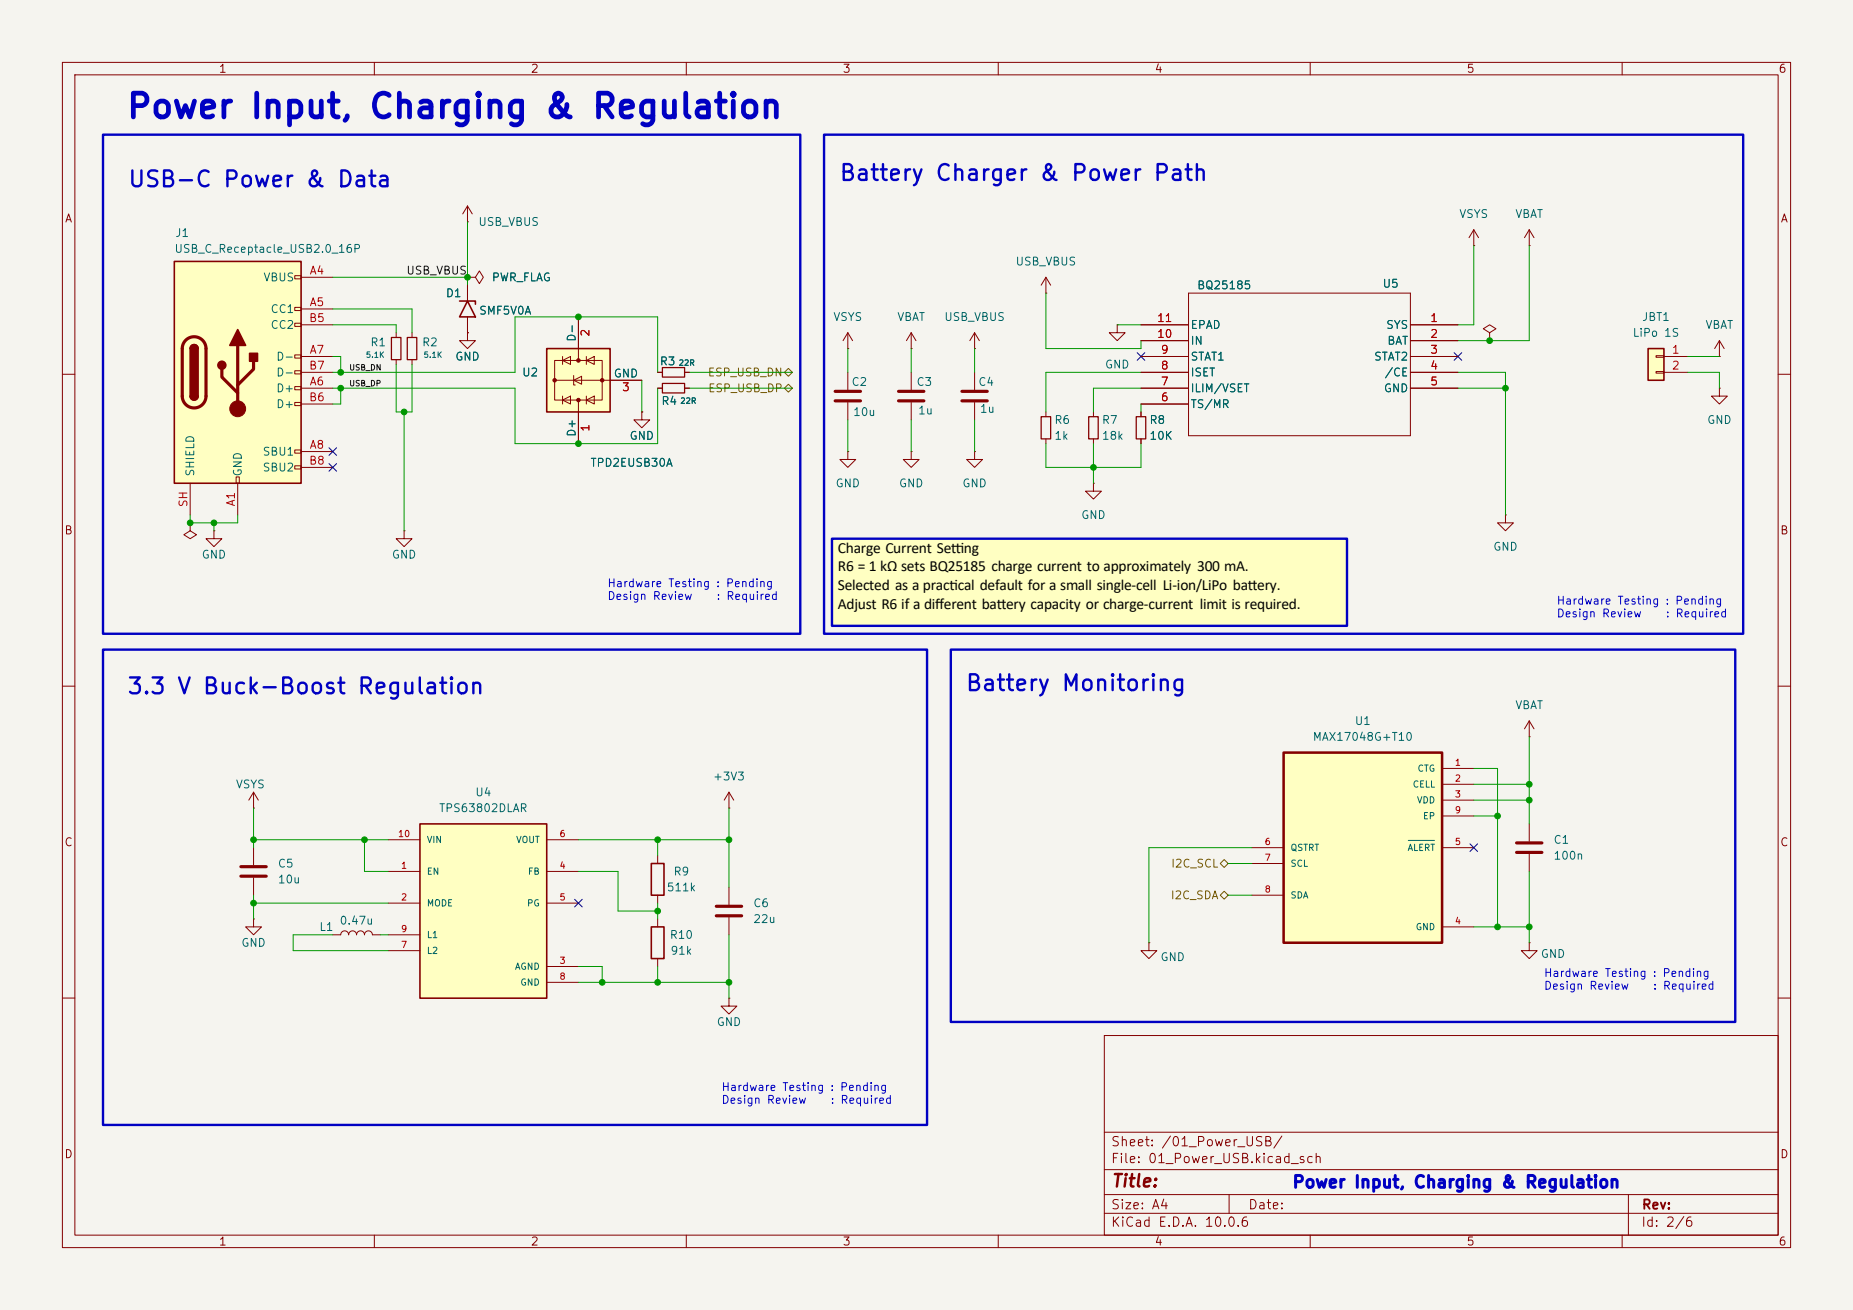
[picture p44: page 2]

Power Input, Charging & Regulation

Battery Charger & Power Path

R6 = 1 kΩ sets BQ25185 charge current to approximately 300 mA.
Selected as a practical default for a small single-cell Li-ion/LiPo battery.
Adjust R6 if a different battery capacity or charge-current limit is required.

D Date:

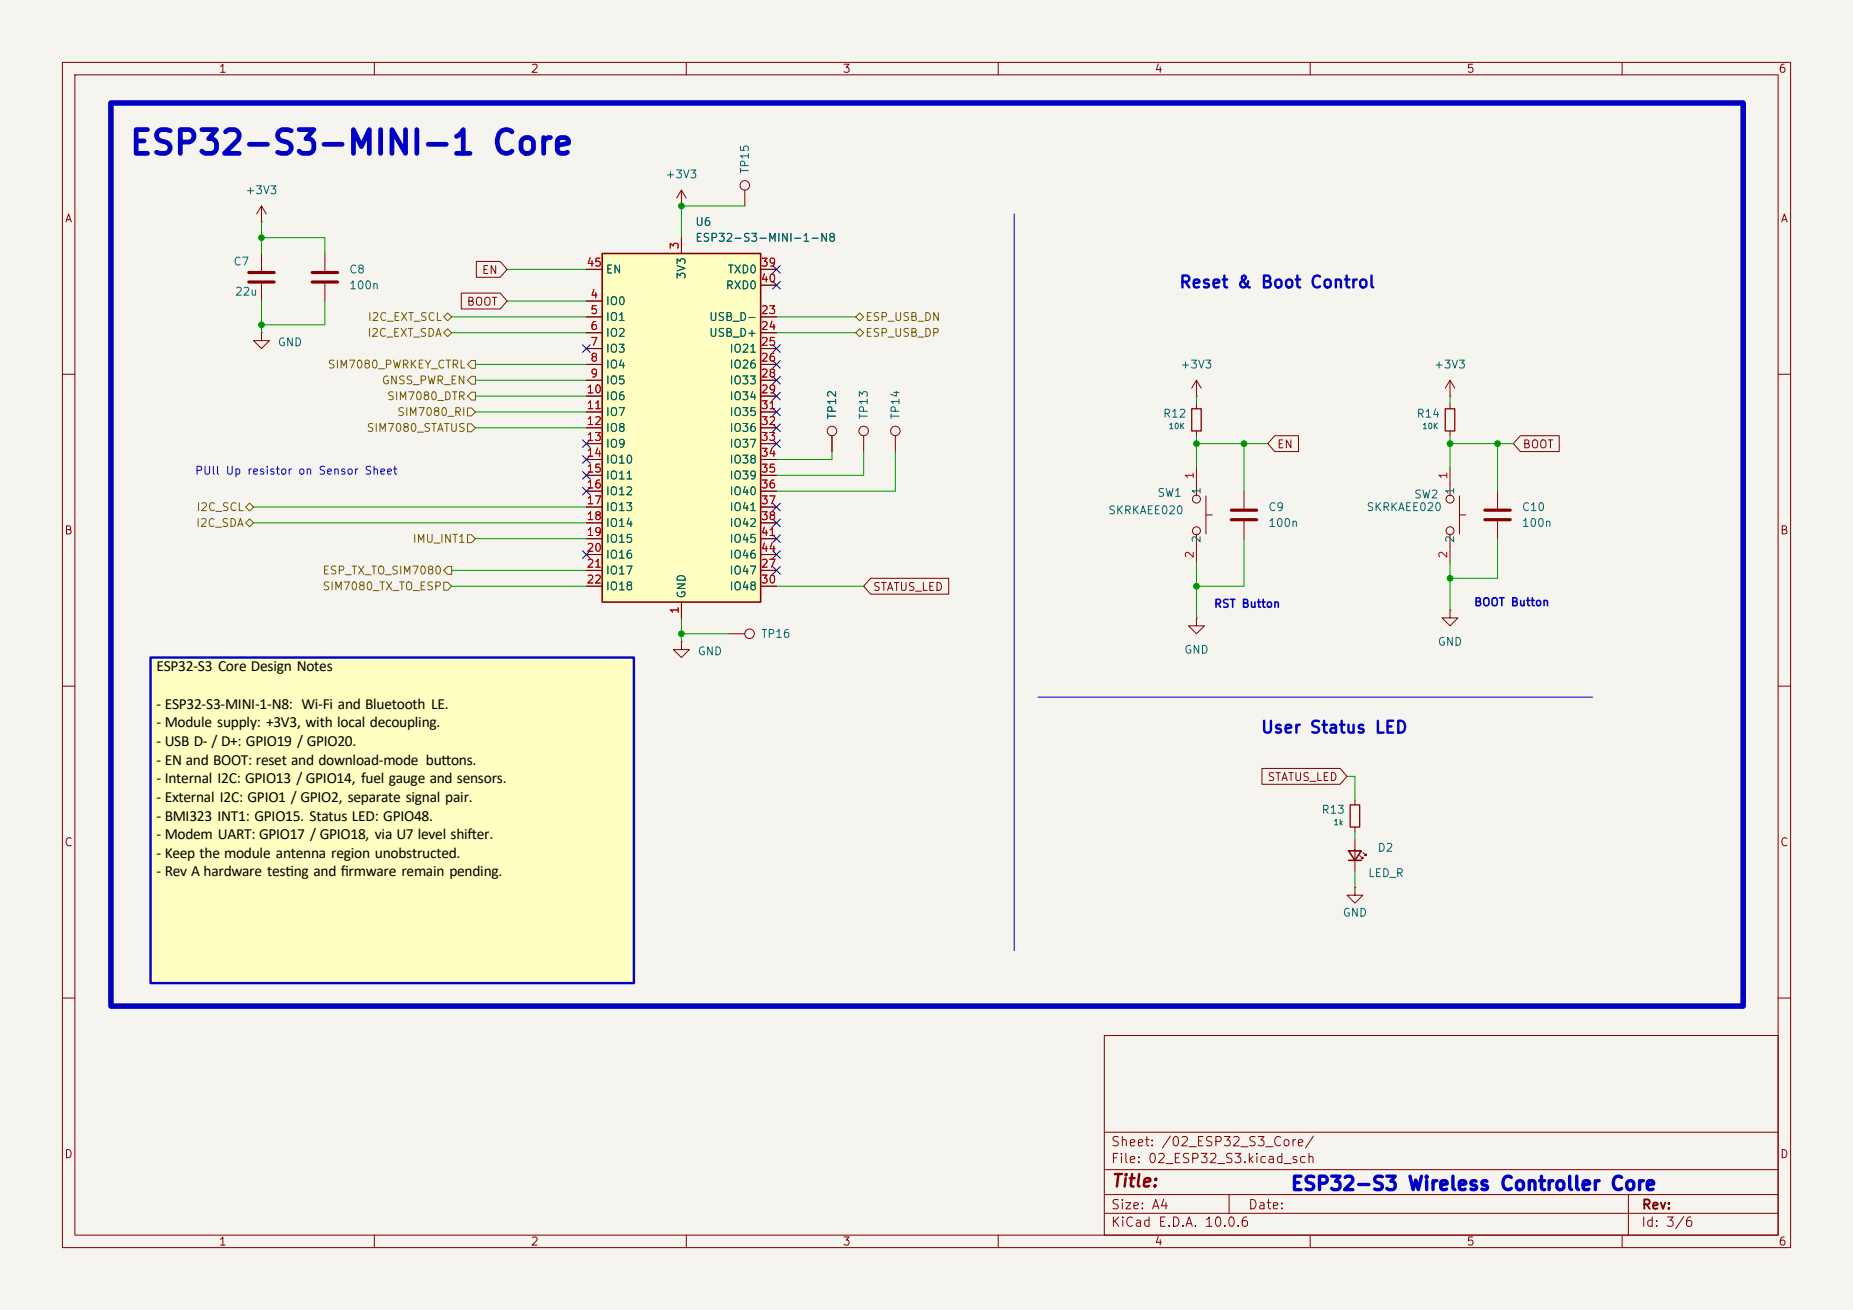
[picture p45: page 3]

RST Button ESP32-S3-MINI-1 Core
GND +3V3
ESP32-S3-MINI-1-N8 GND

BOOT ESP32-S3 Core Design Notes

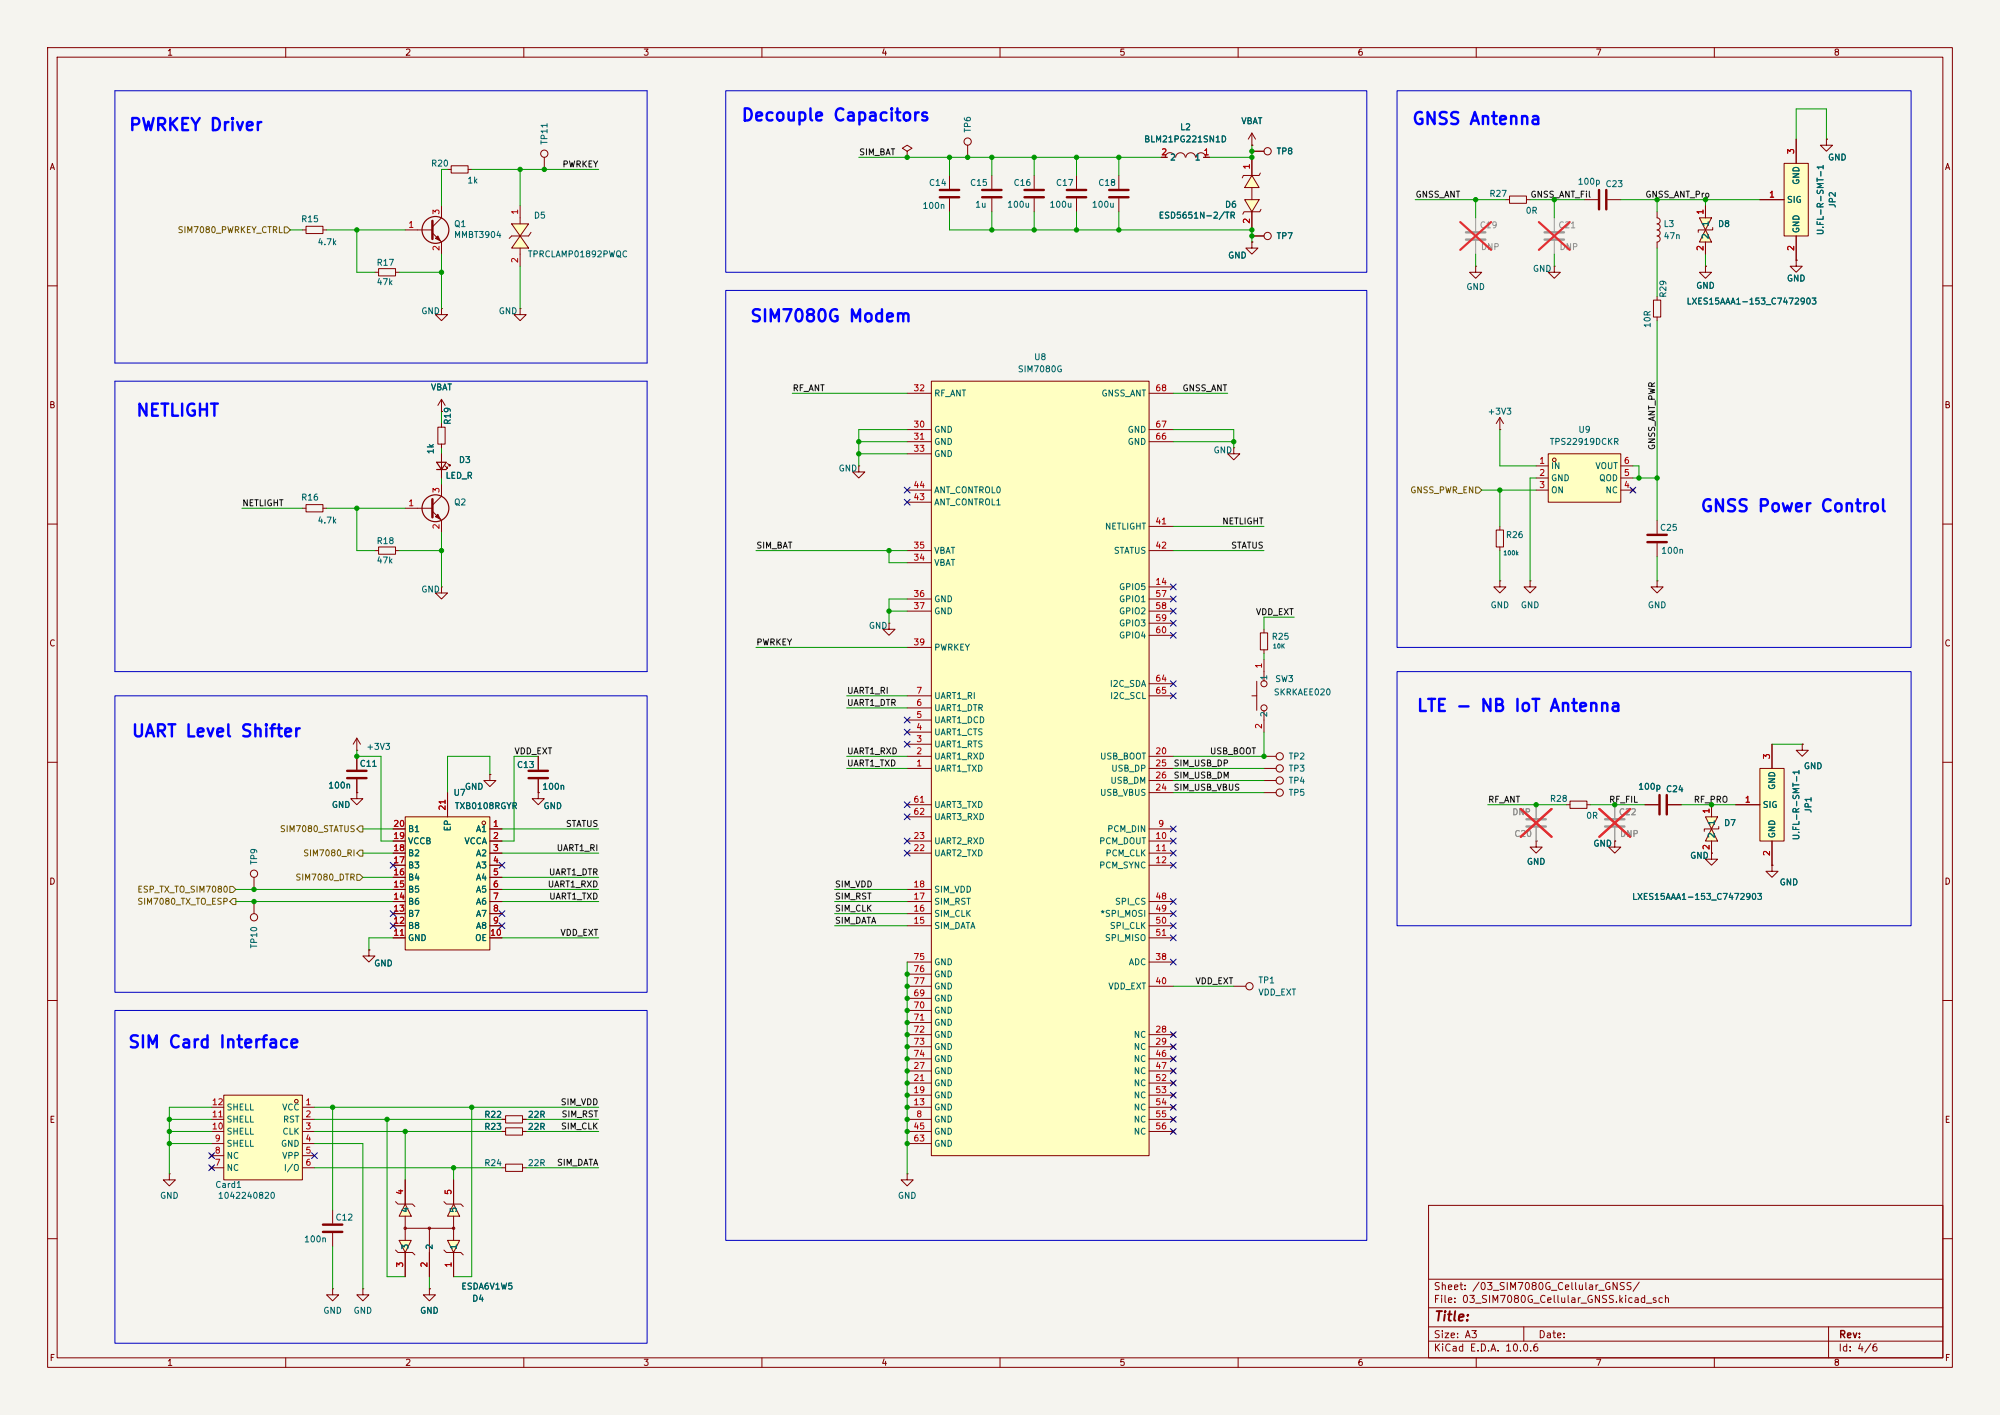
[picture p46: page 4]

3 JP2 U.FL-R-SMT-1 GND UART1_TXD 1 UART1_RXD 2 UART1_RTS 3 UART1_CTS 4 UART1_DCD 5 UART1_DTR 6 UART1_RI 7 GND 8 PCM_DIN 9 PCM_DOUT 10 PCM_CLK 11 PCM_SYNC 12 GND 13

LTE - NB IoT Antenna

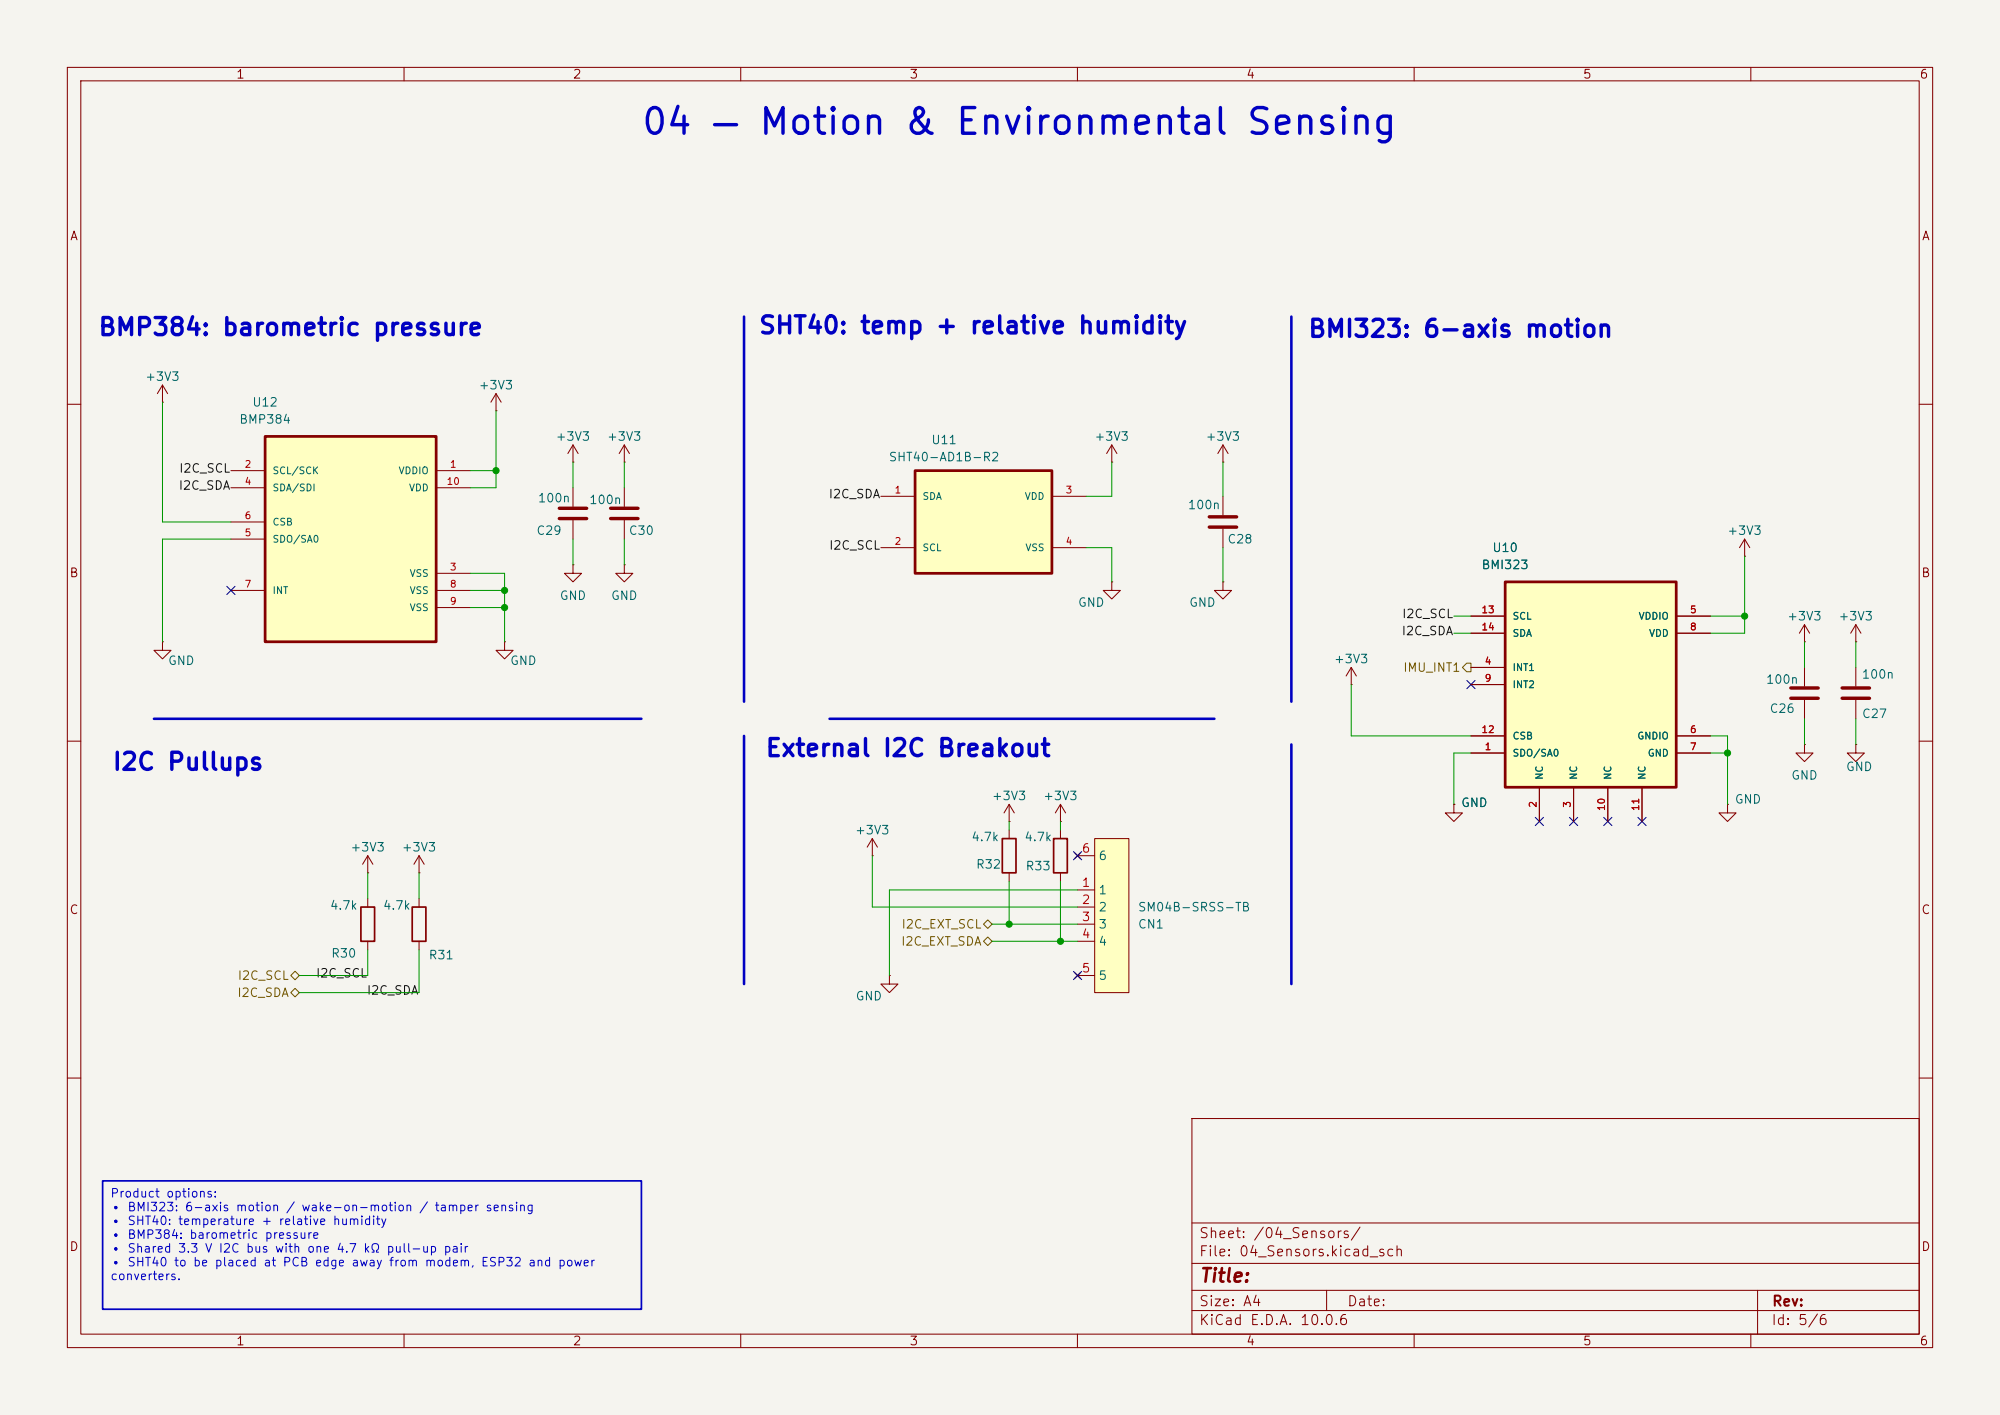
[picture p47: page 5]

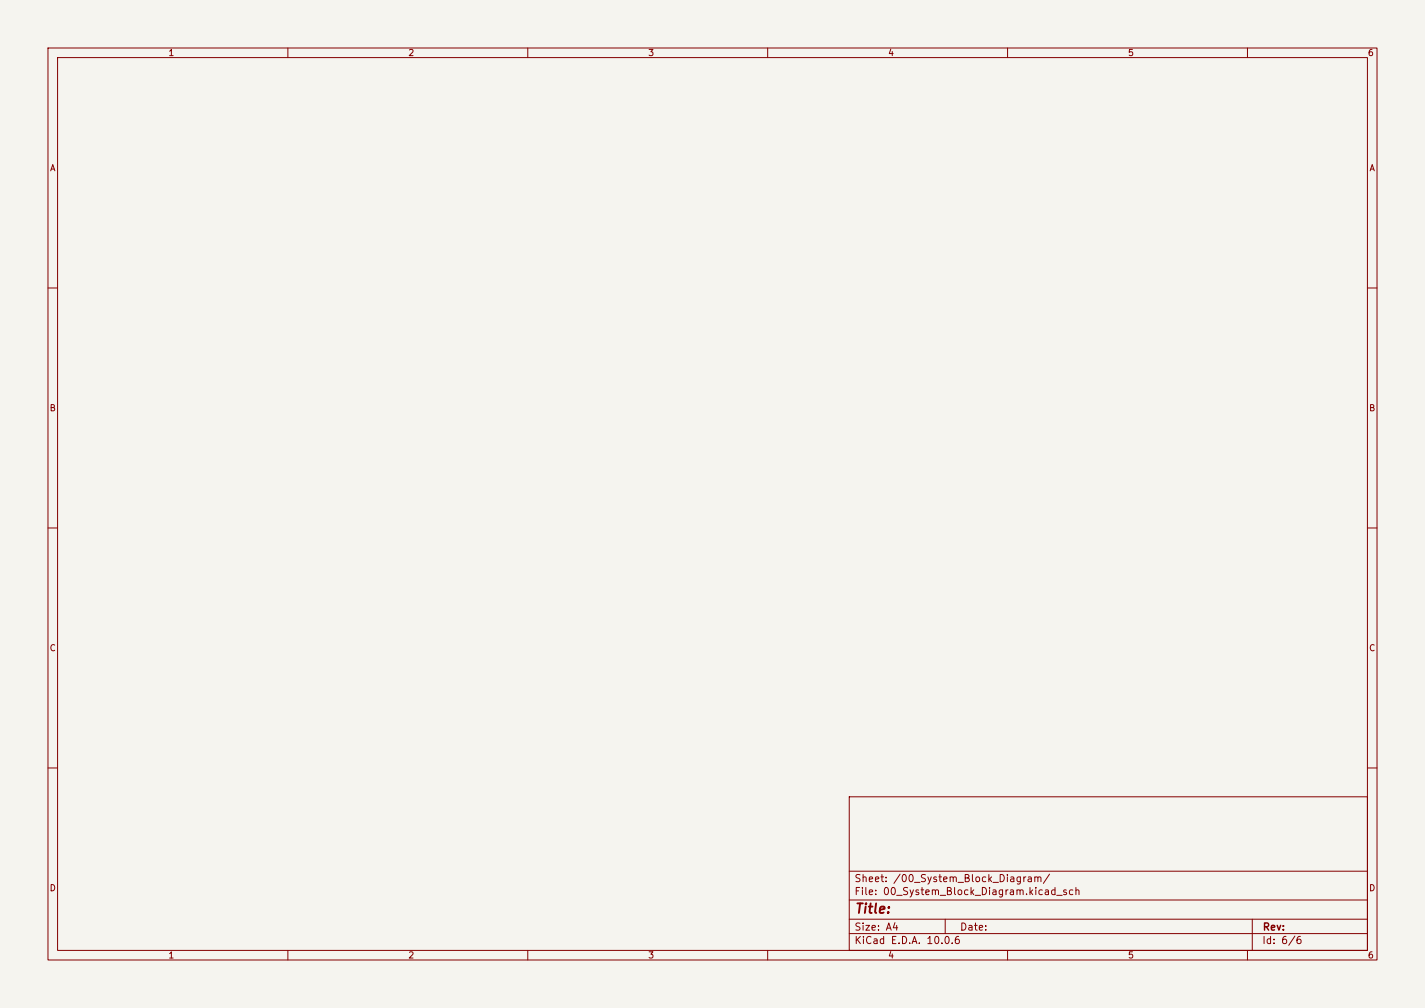
[picture p48: page 6]
