CDonohoe-Designs/EdgeLink_S3_Cellular/hardware/kicad/EdgeLink_S3_Cellular_RevA/EdgeLink_S3_Cellular.kicad_pcb

## KiCad design hardware/kicad/EdgeLink_S3_Cellular_RevA/EdgeLink_S3_Cellular.kicad_pcb (2026-10-12)

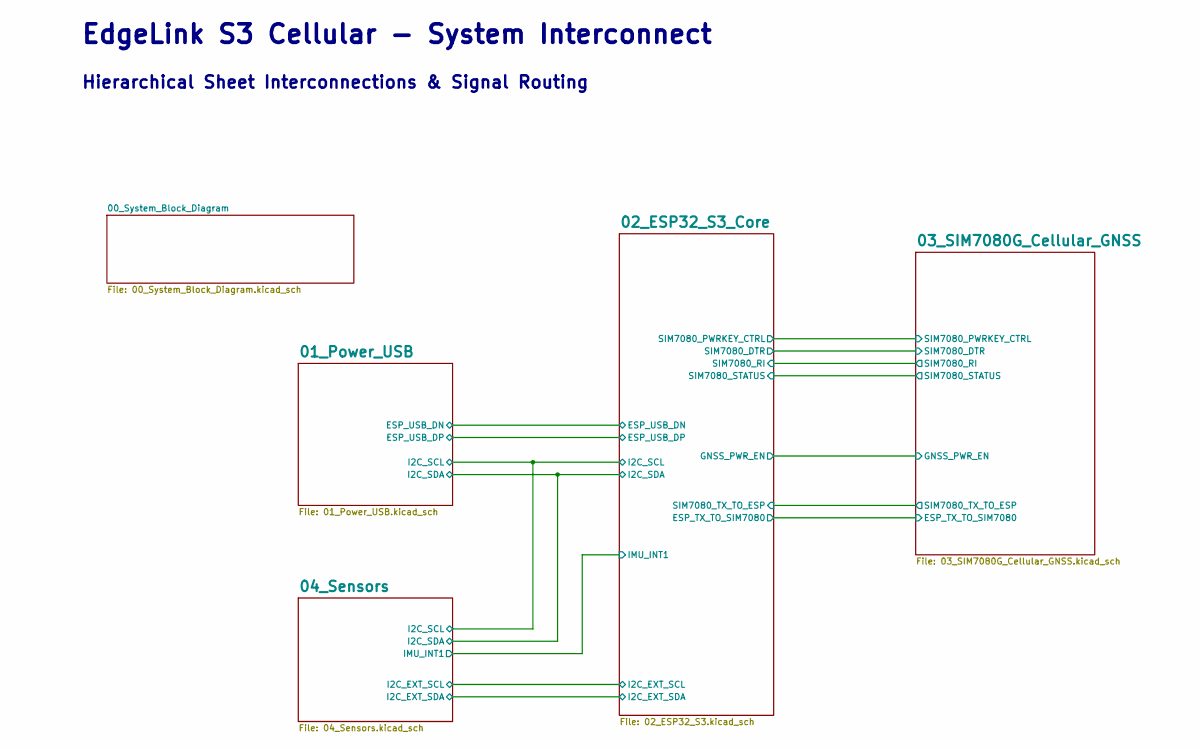
[picture p49: schematic EdgeLink_S3_Cellular.kicad_sch]

Notes on the sheet:
Hierarchical Sheet Interconnections & Signal Routing
EdgeLink S3 Cellular - System Interconnect

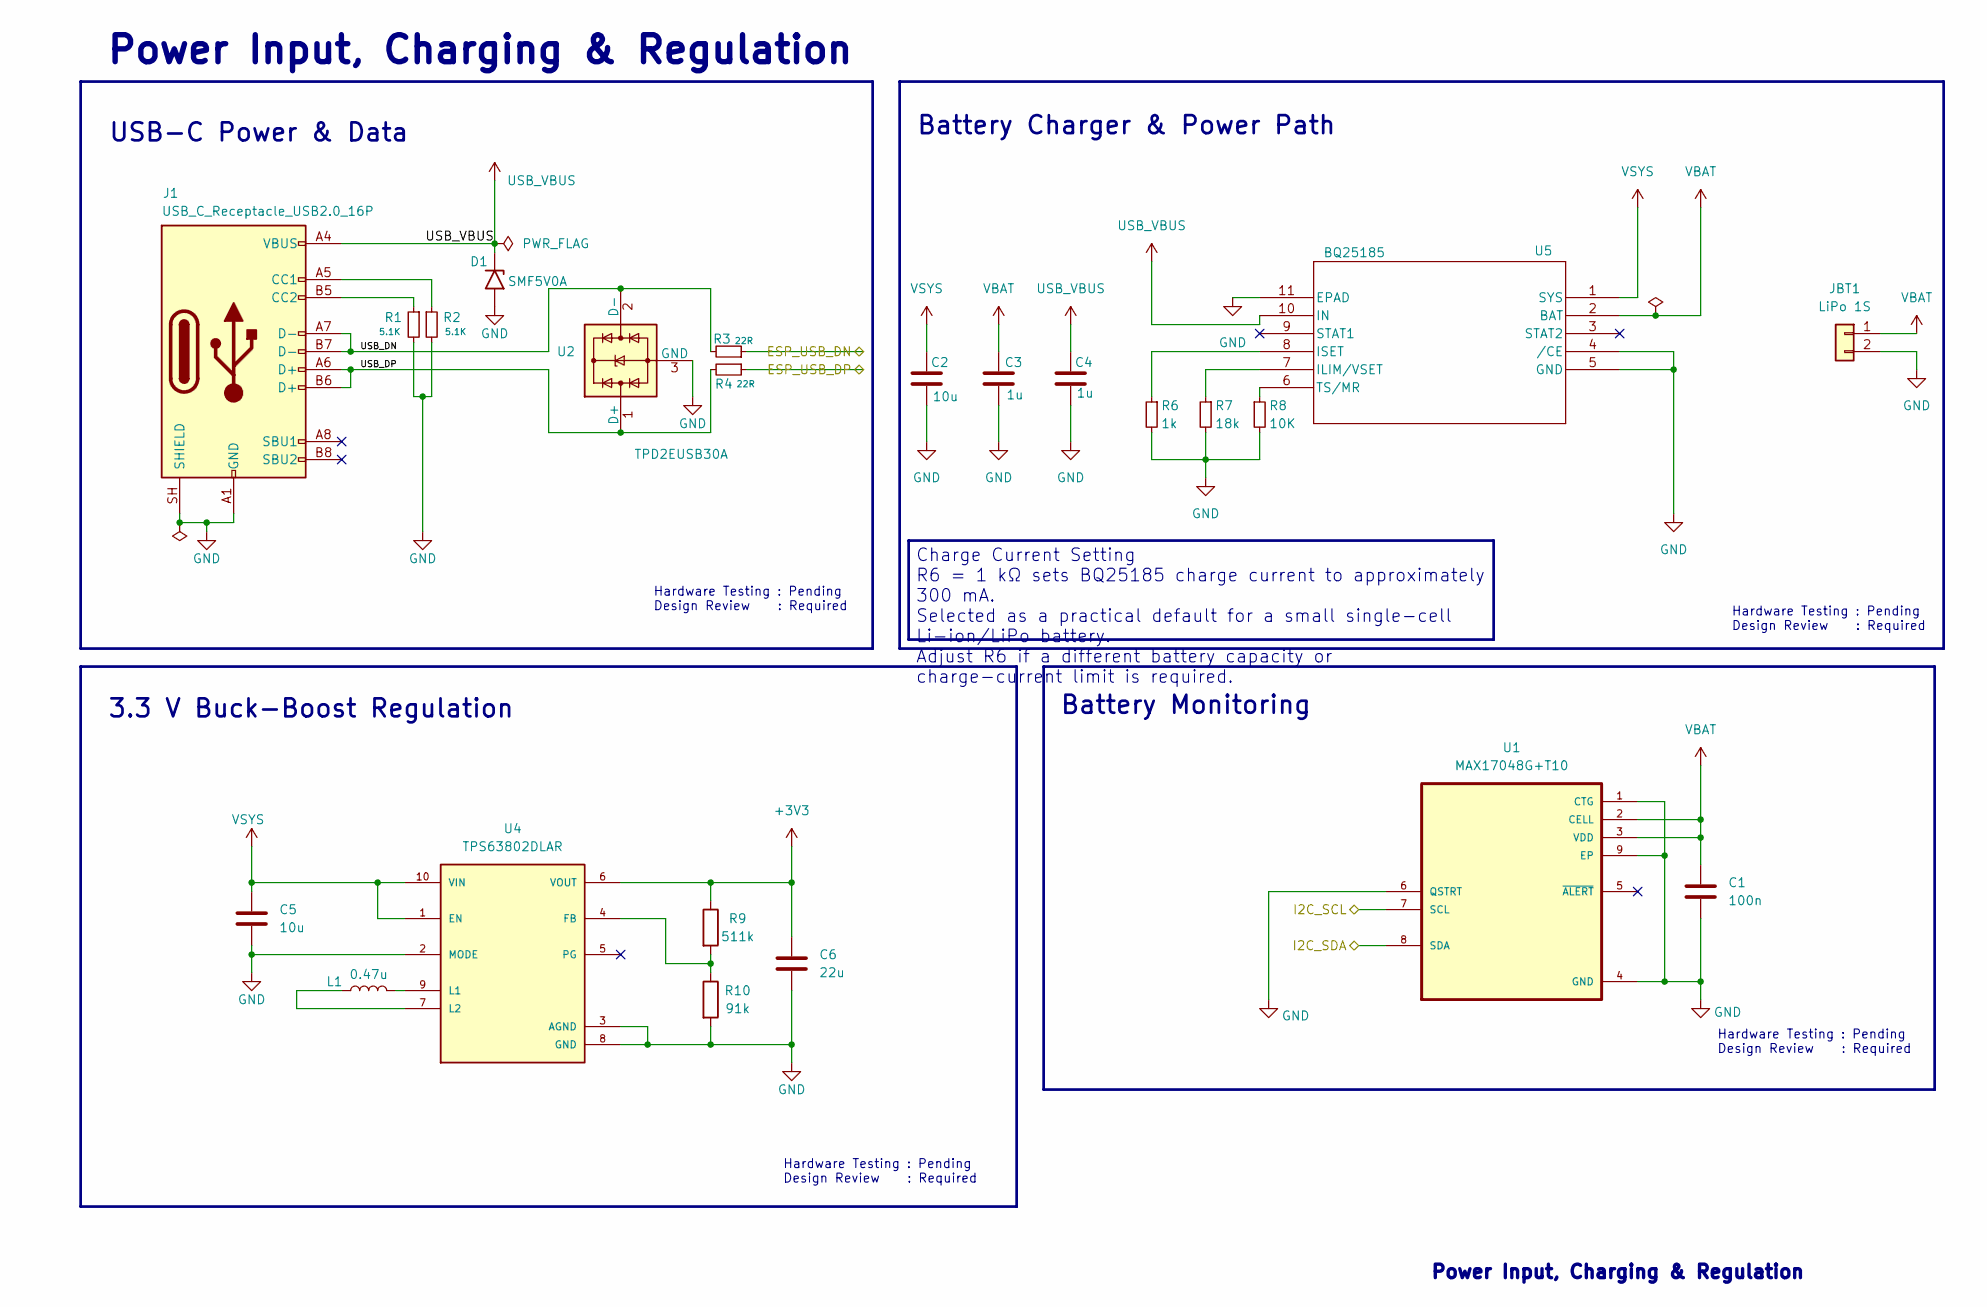
[picture p50: schematic 01_Power_USB.kicad_sch]

Parts:
C1: 100n; C_0402_1005Metric; MPN CL05B104KB54PNC; LCSC Part C307331
C2, C5: 10u; C_0603_1608Metric; MPN GRM188R61E106MA73D; LCSC Part C91606
C3, C4: 1u; C_0402_1005Metric; MPN CL05A105KA5NQNC; LCSC Part C52923
C6: 22u; C_0603_1608Metric; MPN CL10A226MO7JZNC; LCSC Part C2762594
D1: SMF5V0A; D_SMF; MPN SMF5V0A-E3-08; LCSC Part C1972946
J1: USB_C_Receptacle_USB2.0_16P; USB_C_Receptacle_GCT_USB4105-xx-A_16P_TopMnt_Horizontal; MPN USB4105-GF-A; digikey# 2073-USB4215-03-ACT-ND
JBT1: LiPo 1S; JST_PH_S2B-PH-SM4-TB_1x02-1MP_P2.00mm_Horizontal; MPN S2B-PH-SM4-TB(LF)(SN); LCSC Part C295747
L1: 0.47u; INDC2016X120N; MPN DFE201612E-R47M=P2; LCSC Part C668312
R1, R2: 5.1K; R_0402_1005Metric; MPN FRC0402F5101TS; digikey# YAG1696CT-ND
R3, R4: 22R; R_0402_1005Metric; MPN FRC0402F22R0TS; digikey# YAG1696CT-ND
R6: 1k; R_0402_1005Metric; MPN FRC0402F1001TS; LCSC Part C2906864
R7: 18k; R_0402_1005Metric; MPN FRC0402F1802TS; LCSC Part C2909327
R8: 10K; R_0402_1005Metric; MPN FRC0402F1002TS; LCSC Part C2906861
R9: 511k; R_0402_1005Metric; MPN FRC0402F5113TS; LCSC Part # C101109
R10: 91k; R_0402_1005Metric; MPN FRC0402F9102TS; LCSC Part # C25803
U1: MAX17048G+T10; TDFN-8-1EP_2x2mm_P0.5mm_EP0.8x1.2mm; MPN MAX17048G+T10; LCSC Part C2682616
U2: TPD2EUSB30A; Texas_DRT-3; MPN TPD2EUSB30ADRTR; LCSC Part C94934
U4: TPS63802DLAR; PARTREV B; LCSC Part # C2845237
U5: BQ25185; WSON10_DLH_TEX; MPN BQ25185DLHR; DigiKey 296-BQ25185DLHRCT-ND

Connections:
+3V3: C6.1, R9.1, U4.6 (VOUT); also elsewhere on the board
/01_Power_USB/ESP_USB_DN: R3.1; also elsewhere on the board
/01_Power_USB/ESP_USB_DP: R4.1; also elsewhere on the board
/01_Power_USB/USB_DN: J1.A7 (D-), J1.B7 (D-), R3.2, U2.2 (D-)
/01_Power_USB/USB_DP: J1.A6 (D+), J1.B6 (D+), R4.2, U2.1 (D+)
/04_Sensors/I2C_SCL: U1.7 (SCL); also elsewhere on the board
/04_Sensors/I2C_SDA: U1.8 (SDA); also elsewhere on the board
GND: C1.2, C2.2, C3.2, C4.2, C5.2, C6.2, D1.2 (A2), J1.A1 (GND), J1.A12 (GND), J1.B1 (GND), J1.B12 (GND), J1.SH (SHIELD), JBT1.2, R1.2, R2.2, R6.2, R7.2, R8.2, R10.2, U1.1 (CTG), U1.4 (GND), U1.6 (QSTRT), U1.9 (EP), U2.3 (GND), U4.2 (MODE), U4.3 (AGND), U4.8 (GND), U5.4 (/CE), U5.5 (GND), U5.11 (EPAD); also elsewhere on the board
unnamed: J1.A5 (CC1), R2.1
unnamed: J1.B5 (CC2), R1.1
unnamed: R9.2, R10.1, U4.4 (FB)
unnamed: L1.2, U4.9 (L1)
unnamed: L1.1, U4.7 (L2)
unnamed: R7.1, U5.7 (ILIM/VSET)
unnamed: R6.1, U5.8 (ISET)
unnamed: R8.1, U5.6 (TS/MR)
USB_VBUS: C4.1, D1.1 (A1), J1.A4 (VBUS), J1.A9 (VBUS), J1.B4 (VBUS), J1.B9 (VBUS), U5.10 (IN)
VBAT: C1.1, C3.1, JBT1.1, U1.2 (CELL), U1.3 (VDD), U5.2 (BAT); also elsewhere on the board
VSYS: C2.1, C5.1, U4.1 (EN), U4.10 (VIN), U5.1 (SYS)

Notes on the sheet:
3.3 V Buck-Boost Regulation
Hardware Testing : Pending Design Review : Required
Power Input, Charging & Regulation
USB-C Power & Data
Battery Monitoring
Battery Charger & Power Path
Charge Current Setting R6 = 1 kΩ sets BQ25185 charge current to approximately 300 mA. Selected as a practical default for a small single-cell Li-ion/LiPo battery. Adjust R6 if a different battery capacity or charge-current limit is required.

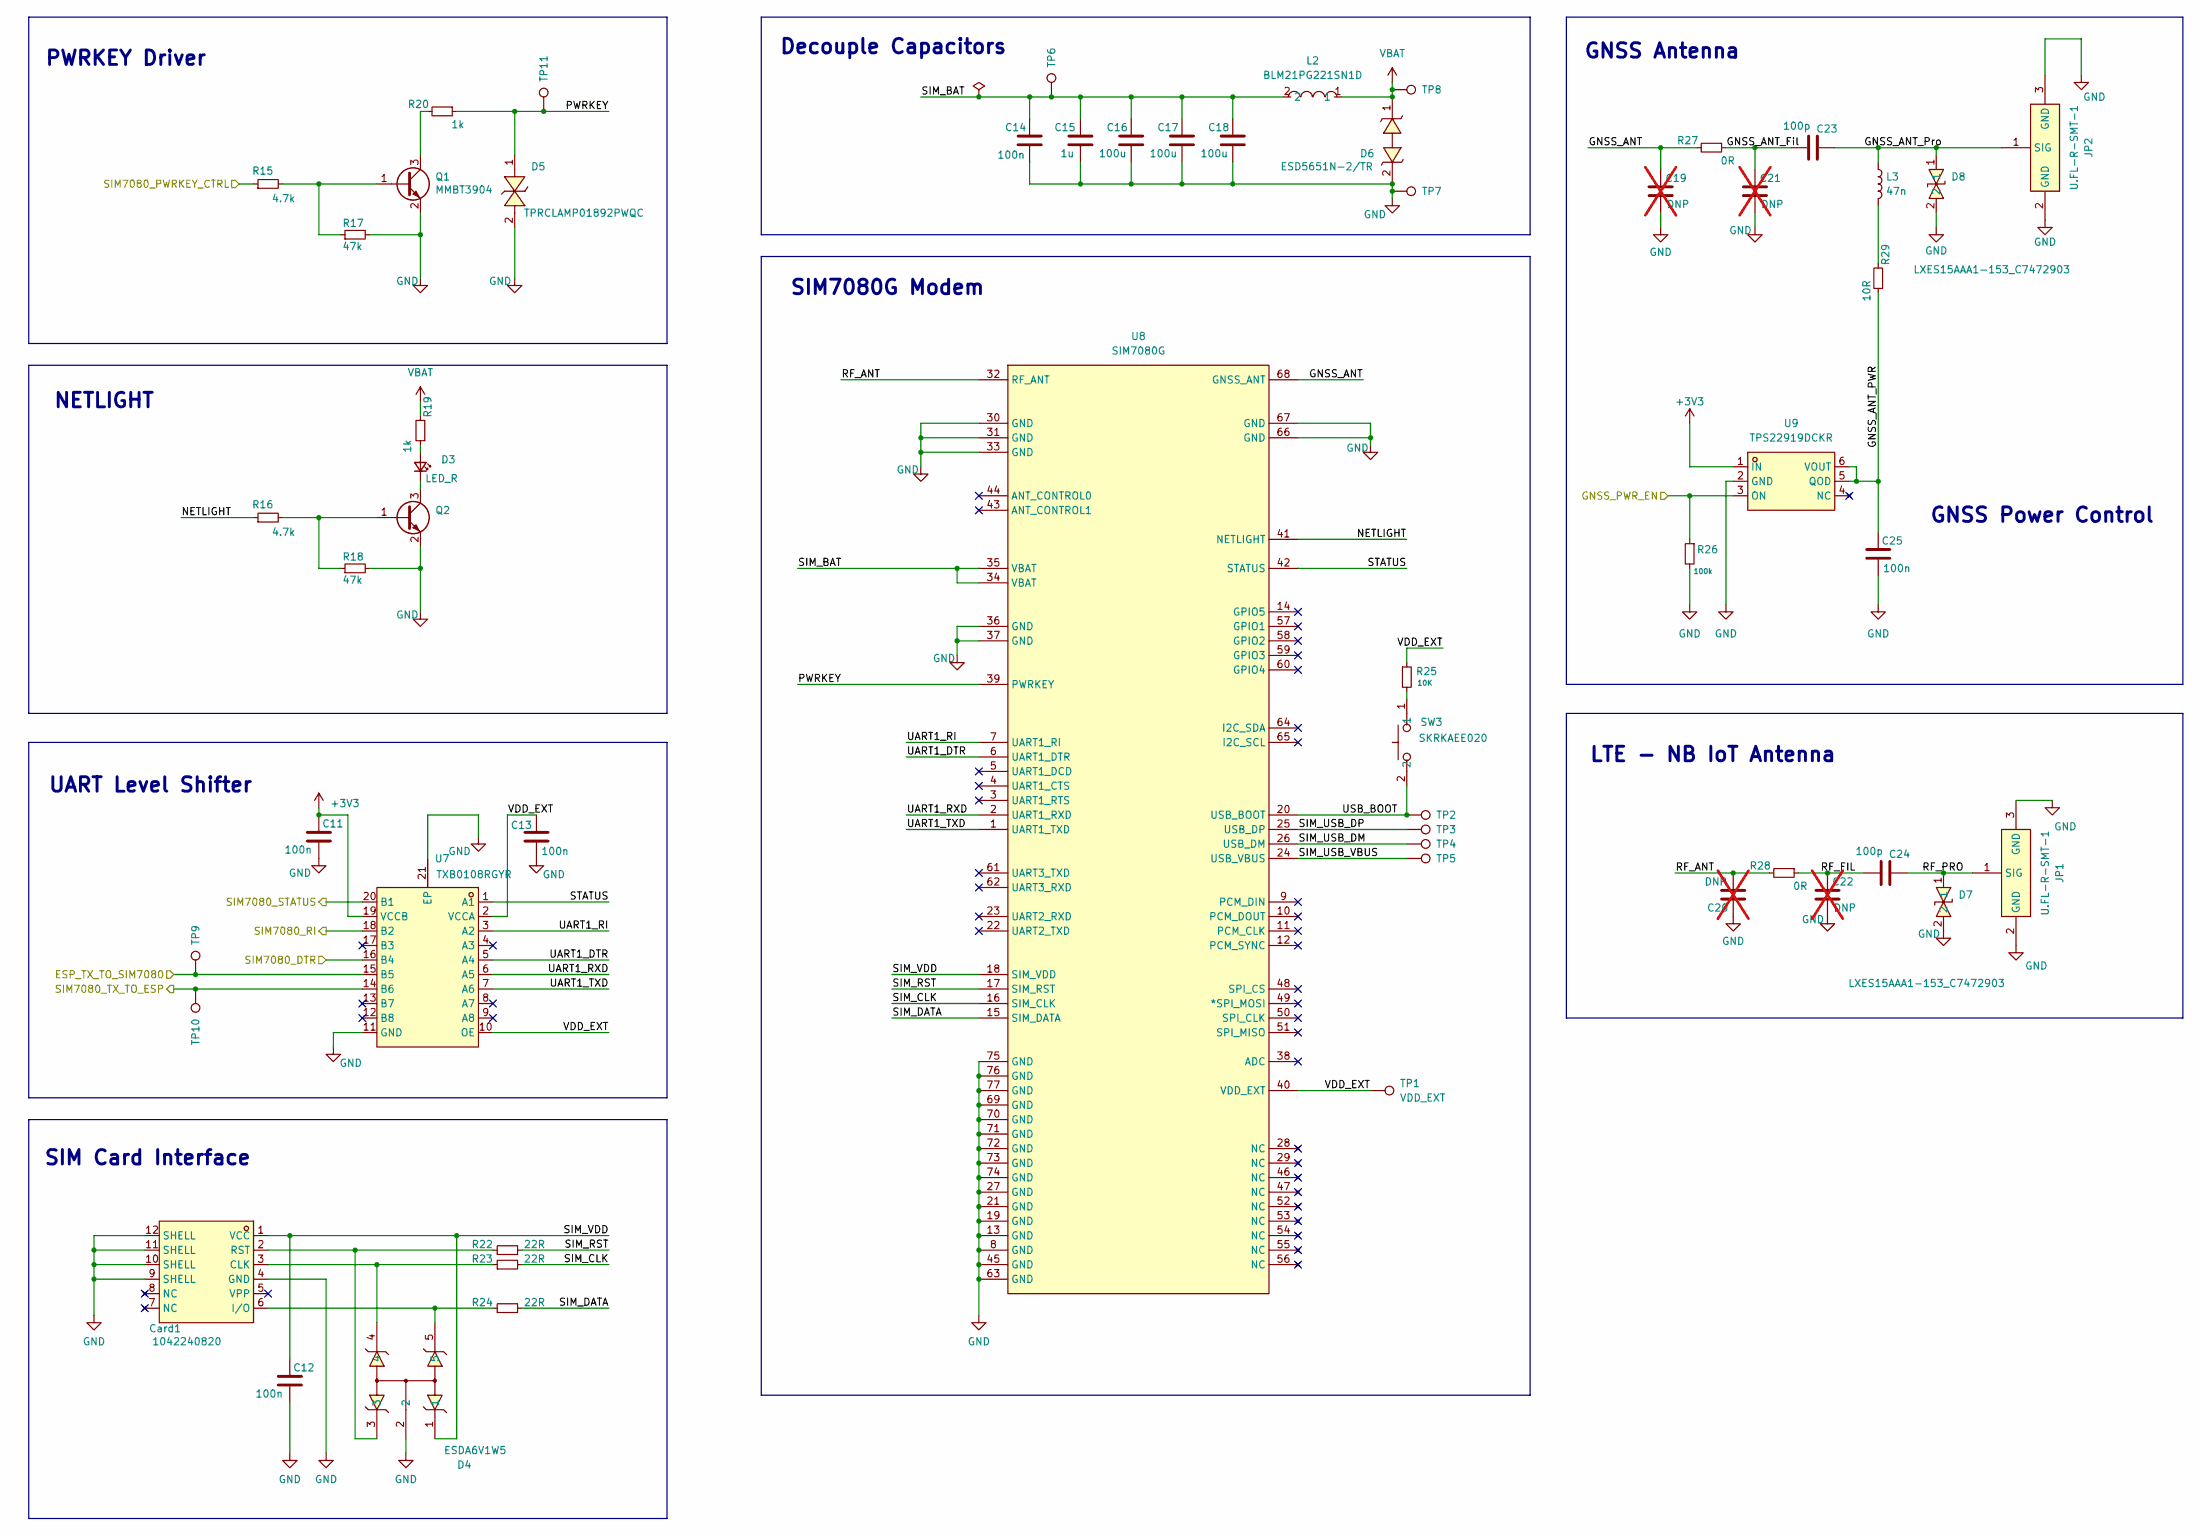
[picture p51: schematic 03_SIM7080G_Cellular_GNSS.kicad_sch]

Parts:
C11, C12, C13: 100n; C_0402_1005Metric; MPN CL05B104KB54PNC; LCSC Part C307331
C14, C25: 100n; C_0603_1608Metric; MPN CC0603KRX7R9BB104; LCSC Part C14663
C15: 1u; C_0402_1005Metric; MPN CL05A105KA5NQNC; LCSC Part C52923
C16, C17, C18: 100u; C_0805_2012Metric; MPN GRM21BR60J107ME15L; LCSC Part C141660
C19, C20, C21, C22: DNP; C_0402_1005Metric; not fitted
C23, C24: 100p; C_0402_1005Metric; MPN GCM1555C1H101JA16D; LCSC Part C126492
Card1: 1042240820; SIM-SMD_1042240820; MPN 1042240820; LCSC Part C585349
D3: LED_R; LED_0603_1608Metric; MPN LTST-C193KRKT-5A; digikey# 160-1830-1-ND
D4: ESDA6V1W5; SC-70-5_L2.1-W1.3-P0.65-LS2.1-BR; MPN ESDA6V1W5; LCSC Part C48677
D5: TPRCLAMP01892PWQC; DFN1006-2L-BI-1; MPN TPRCLAMP01892PWQC; LCSC Part C52098254
D6: ESD5651N-2/TR; DFN1006-2L-BI-1; MPN ESD5651N-2/TR; LCSC Part C239784
D7, D8: LXES15AAA1-153_C7472903; DFN1006-2L-BI; MPN LXES15AAA1-153; LCSC Part C7472903
JP1, JP2: U.FL-R-SMT-1; RF-SMD_FRF05002-JSS103M; MPN U.FL-R-SMT-1(80); LCSC Part C88374
L2: BLM21PG221SN1D; L0805; MPN BLM21PG221SN1D; LCSC Part C85840
L3: 47n; L_0402_1005Metric; MPN 0402DC-47NXJRW; LCSC Part C3221702
Q1, Q2: MMBT3904; SOT-23; MPN MMBT3904; LCSC Part C7420353
R15, R16: 4.7k; R_0402_1005Metric; MPN 0402WGF4701TCE; LCSC Part C25900
R17, R18: 47k; R_0402_1005Metric; MPN 0402WGF4702TCE; LCSC Part C25792
R19, R20: 1k; R_0402_1005Metric; MPN FRC0402F1001TS; LCSC Part C2906864
R22, R23, R24: 22R; R_0402_1005Metric; MPN FRC0402F22R0TS; LCSC Part C2929994
R25: 10K; R_0402_1005Metric; MPN FRC0402F1002TS; digikey# YAG1236CT-ND
R26: 100k; R_0402_1005Metric; MPN FRC0402F1003TS; digikey# YAG1696CT-ND
R27, R28: 0R; R_0402_1005Metric; MPN CQ02WGF0000TCE; LCSC Part C2770621
R29: 10R; R_0402_1005Metric; MPN FRC0402F10R0TS; LCSC Part C2906862
SW3: SKRKAEE020; SW-SMD_L3.9-W3.0-P4.45; MPN SKRKAEE020; LCSC Part C115357
TP1: VDD_EXT; TestPoint_Pad_D1.0mm
TP2: USB_BOOT; TestPoint_Pad_D1.0mm
TP3: SIM_USB_DP; TestPoint_Pad_D1.0mm
TP4: SIM_USB_DM; TestPoint_Pad_D1.0mm
TP5: SIM_USB_VBUS; TestPoint_Pad_D1.0mm
TP6: SIM_BAT; TestPoint_Pad_D1.0mm
TP7: GND; TestPoint_Pad_D1.0mm
TP8: VBAT; TestPoint_Pad_D1.0mm
TP9: ESP_TX_TO_SIM7080; TestPoint_Pad_D1.0mm
TP10: SIM7080_TX_TO_ESP; TestPoint_Pad_D1.0mm
TP11: PWRKEY; TestPoint_Pad_D1.0mm
U7: TXB0108RGYR; VQFN-20_L4.5-W3.5-P0.50-BL-EP; MPN TXB0108RGYR; LCSC Part C194701
U8: SIM7080G; LCC-SMD_SIM7080G; MPN SIM7080G; LCSC Part C2943992
U9: TPS22919DCKR; SC-70-6_L2.2-W1.3-P0.65-LS2.1-BR; MPN TPS22919DCKR; LCSC Part C2149796

Connections:
+3V3: C11.1, U7.19 (VCCB), U9.1 (IN); also elsewhere on the board
/02_ESP32_S3_Core/ESP_TX_TO_SIM7080: TP9.1 (1_1), U7.15 (B5); also elsewhere on the board
/02_ESP32_S3_Core/GNSS_PWR_EN: R26.1, U9.3 (ON); also elsewhere on the board
/02_ESP32_S3_Core/SIM7080_DTR: U7.16 (B4); also elsewhere on the board
/02_ESP32_S3_Core/SIM7080_PWRKEY_CTRL: R15.1; also elsewhere on the board
/02_ESP32_S3_Core/SIM7080_RI: U7.18 (B2); also elsewhere on the board
/02_ESP32_S3_Core/SIM7080_STATUS: U7.20 (B1); also elsewhere on the board
/02_ESP32_S3_Core/SIM7080_TX_TO_ESP: TP10.1 (1_1), U7.14 (B6); also elsewhere on the board
/03_SIM7080G_Cellular_GNSS/GNSS_ANT: C19.1, R27.2, U8.68 (GNSS_ANT)
/03_SIM7080G_Cellular_GNSS/GNSS_ANT_Fil: C21.1, C23.2, R27.1
/03_SIM7080G_Cellular_GNSS/GNSS_ANT_PWR: C25.1, R29.1, U9.5 (QOD), U9.6 (VOUT)
/03_SIM7080G_Cellular_GNSS/GNSS_ANT_Pro: C23.1, D8.1, JP2.1 (SIG), L3.1
/03_SIM7080G_Cellular_GNSS/NETLIGHT: R16.1, U8.41 (NETLIGHT)
/03_SIM7080G_Cellular_GNSS/PWRKEY: D5.1, R20.1, TP11.1 (1_1), U8.39 (PWRKEY)
/03_SIM7080G_Cellular_GNSS/RF_ANT: C20.2, R28.2, U8.32 (RF_ANT)
/03_SIM7080G_Cellular_GNSS/RF_FIL: C22.1, C24.2, R28.1
/03_SIM7080G_Cellular_GNSS/RF_PRO: C24.1, D7.1, JP1.1 (SIG)
/03_SIM7080G_Cellular_GNSS/SIM_BAT: C14.1, C15.1, C16.1, C17.1, C18.1, L2.2, TP6.1 (1_1), U8.34 (VBAT), U8.35 (VBAT)
/03_SIM7080G_Cellular_GNSS/SIM_CLK: R23.2, U8.16 (SIM_CLK)
/03_SIM7080G_Cellular_GNSS/SIM_DATA: R24.2, U8.15 (SIM_DATA)
/03_SIM7080G_Cellular_GNSS/SIM_RST: R22.2, U8.17 (SIM_RST)
/03_SIM7080G_Cellular_GNSS/SIM_USB_DM: TP4.1 (1_1), U8.26 (USB_DM)
/03_SIM7080G_Cellular_GNSS/SIM_USB_DP: TP3.1 (1_1), U8.25 (USB_DP)
/03_SIM7080G_Cellular_GNSS/SIM_USB_VBUS: TP5.1 (1_1), U8.24 (USB_VBUS)
/03_SIM7080G_Cellular_GNSS/SIM_VDD: C12.1, Card1.1 (VCC), D4.1, U8.18 (SIM_VDD)
/03_SIM7080G_Cellular_GNSS/STATUS: U7.1 (A1), U8.42 (STATUS)
/03_SIM7080G_Cellular_GNSS/UART1_DTR: U7.5 (A4), U8.6 (UART1_DTR)
/03_SIM7080G_Cellular_GNSS/UART1_RI: U7.3 (A2), U8.7 (UART1_RI)
/03_SIM7080G_Cellular_GNSS/UART1_RXD: U7.6 (A5), U8.2 (UART1_RXD)
/03_SIM7080G_Cellular_GNSS/UART1_TXD: U7.7 (A6), U8.1 (UART1_TXD)
/03_SIM7080G_Cellular_GNSS/USB_BOOT: SW3.2, TP2.1 (1_1), U8.20 (USB_BOOT)
/03_SIM7080G_Cellular_GNSS/VDD_EXT: C13.1, R25.1, TP1.1 (1_1), U7.2 (VCCA), U7.10 (OE), U8.40 (VDD_EXT)
GND: C11.2, C12.2, C13.2, C14.2, C15.2, C16.2, C17.2, C18.2, C19.2, C20.1, C21.2, C22.2, C25.2, Card1.4 (GND), Card1.9 (SHELL), Card1.10 (SHELL), Card1.11 (SHELL), Card1.12 (SHELL), D4.2, D5.2, D6.2, D7.2, D8.2, JP1.2 (GND), JP1.3 (GND), JP2.2 (GND), JP2.3 (GND), Q1.2 (E), Q2.2 (E), R17.2, R18.2, R26.2, TP7.1 (1_1), U7.11 (GND), U7.21 (EP), U8.8 (GND), U8.13 (GND), U8.19 (GND), U8.21 (GND), U8.27 (GND), U8.30 (GND), U8.31 (GND), U8.33 (GND), U8.36 (GND), U8.37 (GND), U8.45 (GND), U8.63 (GND), U8.66 (GND), U8.67 (GND), U8.69 (GND), U8.70 (GND), U8.71 (GND), U8.72 (GND), U8.73 (GND), U8.74 (GND), U8.75 (GND), U8.76 (GND), U8.77 (GND), U9.2 (GND); also elsewhere on the board
unnamed: Card1.3 (CLK), D4.4, R23.1
unnamed: Card1.6 (I/O), D4.5, R24.1
unnamed: Card1.2 (RST), D4.3, R22.1
unnamed: D3.2 (A), R19.1
unnamed: D3.1 (K), Q2.3 (C)
unnamed: L3.2, R29.2
unnamed: Q1.1 (B), R15.2, R17.1
unnamed: Q1.3 (C), R20.2
unnamed: Q2.1 (B), R16.2, R18.1
unnamed: R25.2, SW3.1
VBAT: D6.1, L2.1, R19.2, TP8.1 (1_1); also elsewhere on the board

Notes on the sheet:
UART Level Shifter
Decouple Capacitors
PWRKEY Driver
SIM7080G Modem
GNSS Antenna
LTE - NB IoT Antenna
GNSS Power Control
NETLIGHT
SIM Card Interface

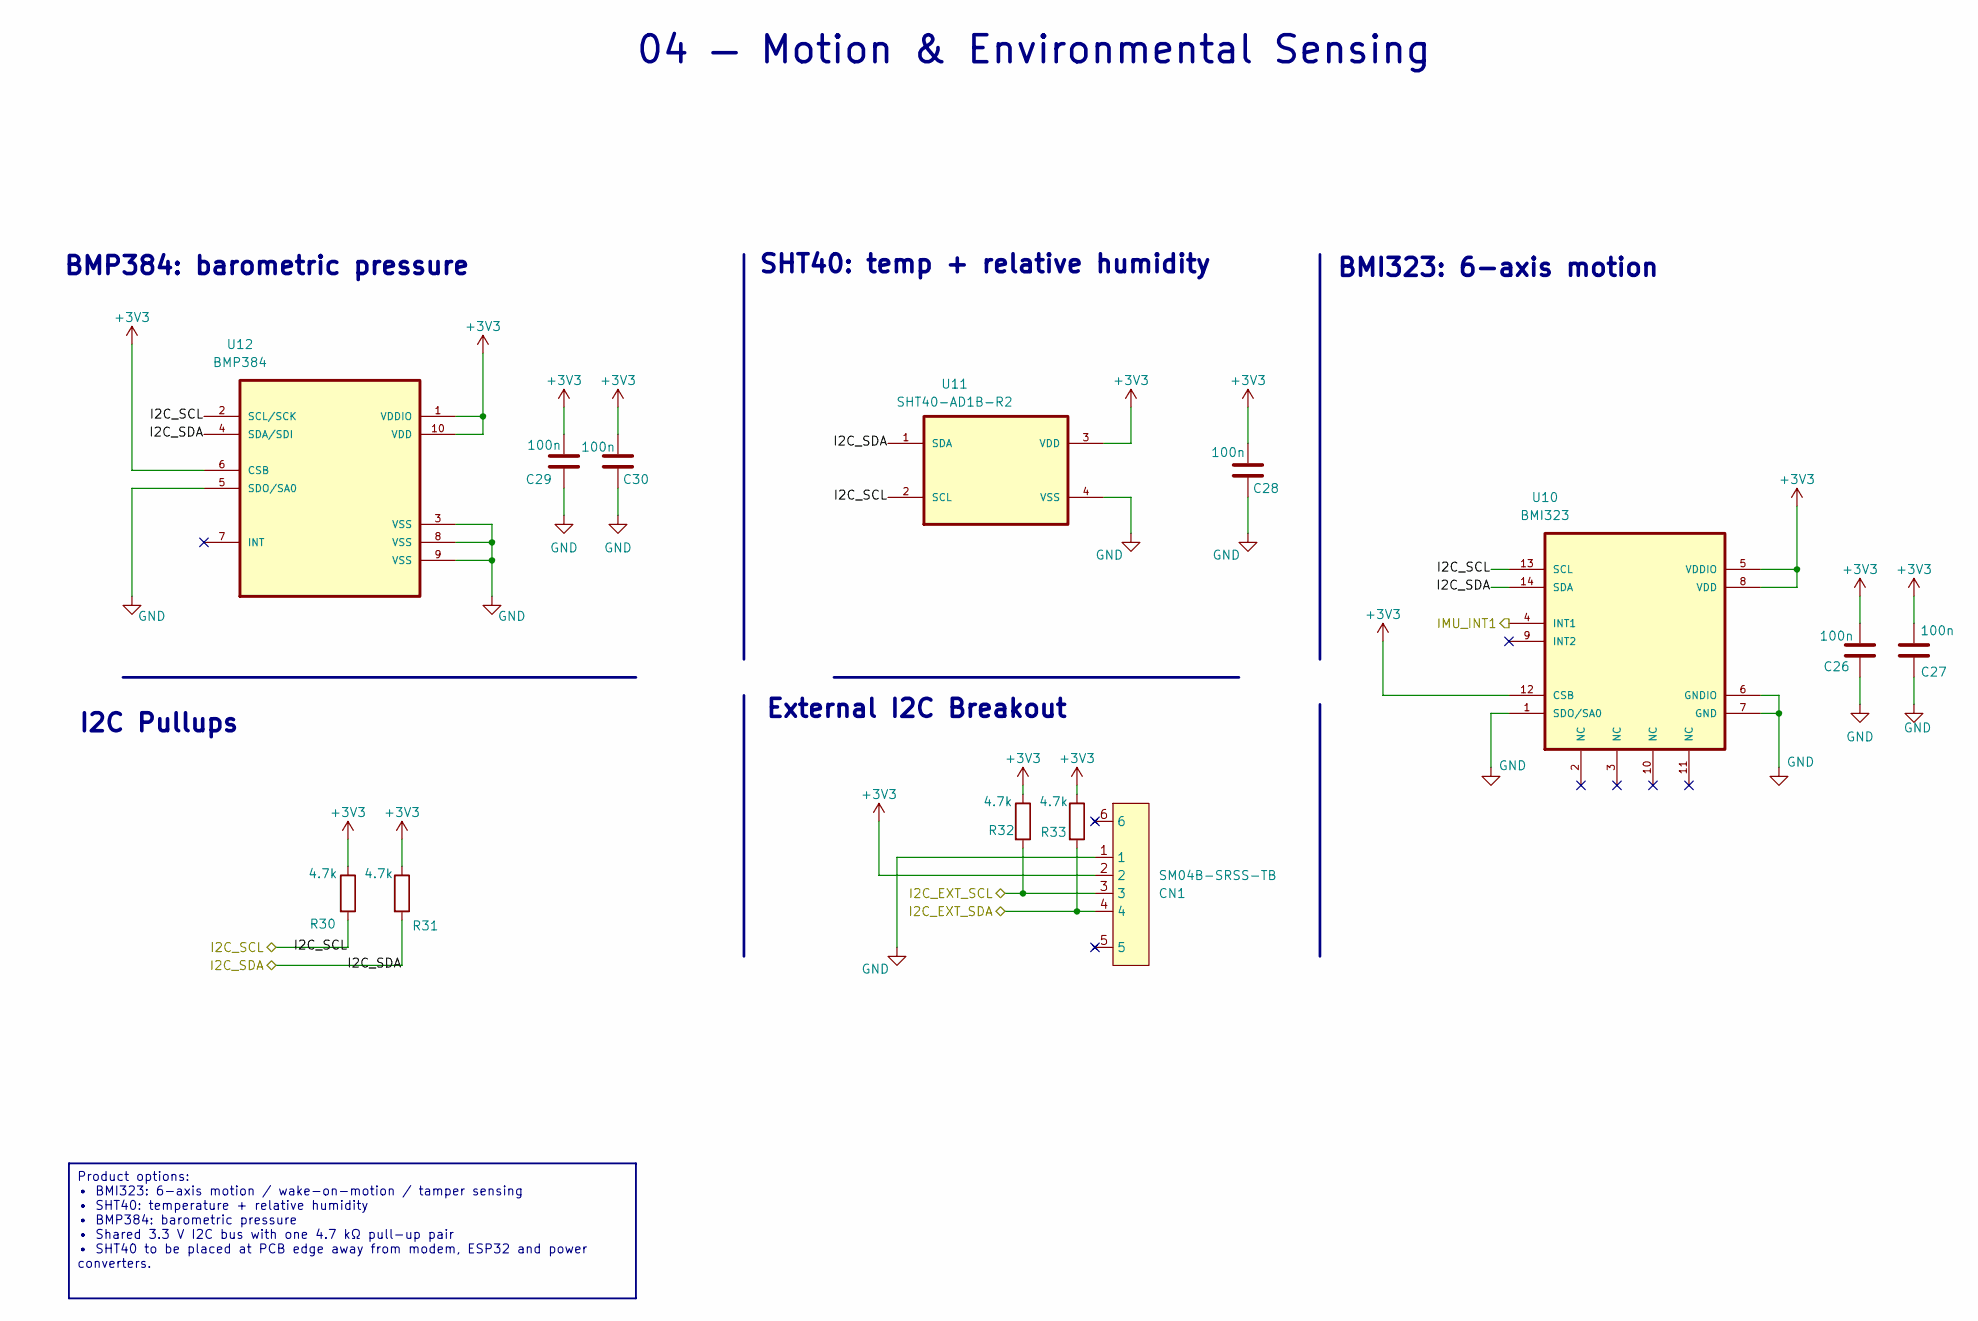
[picture p52: schematic 04_Sensors.kicad_sch]

Parts:
C26, C27, C28, C29, C30: 100n; C_0402_1005Metric; MPN CL05B104KB54PNC; LCSC Part C307331
CN1: SM04B-SRSS-TB; CONN-SMD_4P-P1.00_SM04B-SRSS-TB-LF-SN; MPN SM04B-SRSS-TB(LF)(SN); LCSC Part C160404
R30, R31, R32, R33: 4.7k; R_0402_1005Metric; MPN 0402WGF4701TCE; LCSC Part C25900
U10: BMI323; Bosch_LGA-14_3x2.5mm_P0.5mm; MPN BMI323; LCSC Part # C5368700
U11: SHT40-AD1B-R2; SHT4x_DFN4_1.5x1.5mm; MPN SHT40-AD1B-R2; LCSC Part # C2909890
U12: BMP384; BMP390_LGA10_2x2mm; MPN BMP384; LCSC Part # C5577555

Connections:
+3V3: C26.1, C27.1, C28.1, C29.1, C30.1, CN1.2, R30.1, R31.1, R32.1, R33.1, U10.5 (VDDIO), U10.8 (VDD), U10.12 (CSB), U11.3 (VDD), U12.1 (VDDIO), U12.6 (CSB), U12.10 (VDD); also elsewhere on the board
/02_ESP32_S3_Core/I2C_EXT_SCL: CN1.3, R32.2; also elsewhere on the board
/02_ESP32_S3_Core/I2C_EXT_SDA: CN1.4, R33.2; also elsewhere on the board
/02_ESP32_S3_Core/IMU_INT1: U10.4 (INT1); also elsewhere on the board
/04_Sensors/I2C_SCL: R30.2, U10.13 (SCL), U11.2 (SCL), U12.2 (SCL/SCK); also elsewhere on the board
/04_Sensors/I2C_SDA: R31.2, U10.14 (SDA), U11.1 (SDA), U12.4 (SDA/SDI); also elsewhere on the board
GND: C26.2, C27.2, C28.2, C29.2, C30.2, CN1.1, U10.1 (SDO/SA0), U10.6 (GNDIO), U10.7 (GND), U11.4 (VSS), U12.3 (VSS), U12.5 (SDO/SA0), U12.8 (VSS), U12.9 (VSS); also elsewhere on the board

Notes on the sheet:
SHT40: temp + relative humidity
BMP384: barometric pressure
04 — Motion & Environmental Sensing
BMI323: 6-axis motion
External I2C Breakout
I2C Pullups
Product options: • BMI323: 6-axis motion / wake-on-motion / tamper sensing • SHT40: temperature + relative humidity • BMP384: barometric pressure • Shared 3.3 V I2C bus with one 4.7 kΩ pull-up pair • SHT40 to be placed at PCB edge away from modem, ESP32 and power converters.

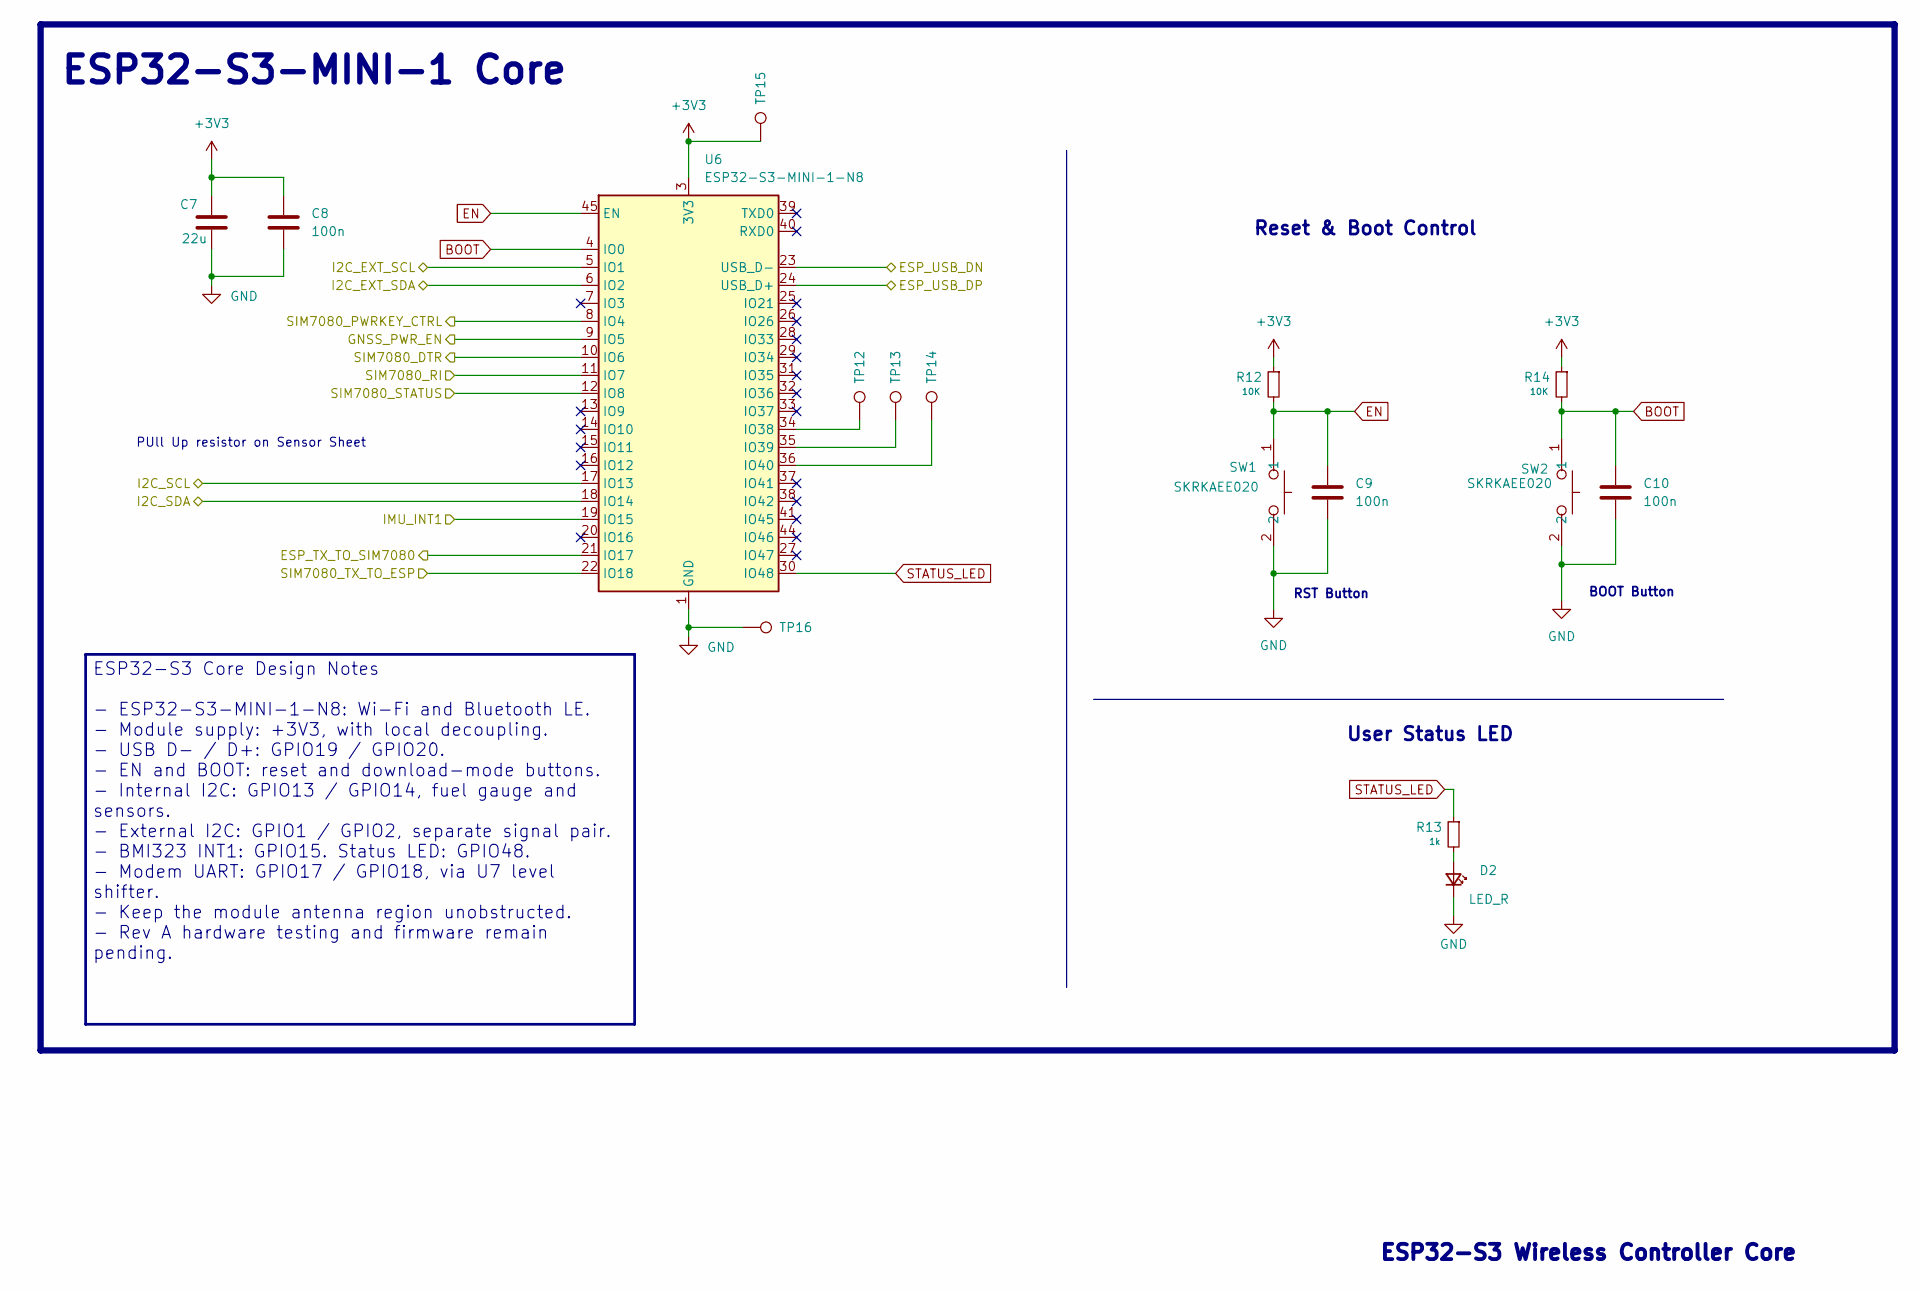
[picture p53: schematic 02_ESP32_S3.kicad_sch]

Parts:
C7: 22u; C_0603_1608Metric; MPN CL10A226MO7JZNC; LCSC Part C2762594
C8, C9, C10: 100n; C_0402_1005Metric; MPN CL05B104KB54PNC; LCSC Part C307331
D2: LED_R; LED_0603_1608Metric; MPN LTST-C193KRKT-5A; digikey# 160-1830-1-ND
R12, R14: 10K; R_0402_1005Metric; MPN FRC0402F1002TS; digikey# YAG1236CT-ND
R13: 1k; R_0402_1005Metric; MPN FRC0402F1001TS; digikey# YAG1696CT-ND
SW1, SW2: SKRKAEE020; SW-SMD_L3.9-W3.0-P4.45; MPN SKRKAEE020; LCSC Part C115357
TP12, TP13, TP14, TP15, TP16: PWRKEY; TestPoint_Pad_D1.0mm
U6: ESP32-S3-MINI-1-N8; ESP32-S2-MINI-1; MPN ESP32-S3-MINI-1-N8; LCSC Part C2913206

Connections:
+3V3: C7.1, C8.1, R12.1, R14.1, TP15.1 (1_1), U6.3 (3V3); also elsewhere on the board
/01_Power_USB/ESP_USB_DN: U6.23 (USB_D-); also elsewhere on the board
/01_Power_USB/ESP_USB_DP: U6.24 (USB_D+); also elsewhere on the board
/02_ESP32_S3_Core/ESP_TX_TO_SIM7080: U6.21 (IO17); also elsewhere on the board
/02_ESP32_S3_Core/GNSS_PWR_EN: U6.9 (IO5); also elsewhere on the board
/02_ESP32_S3_Core/I2C_EXT_SCL: U6.5 (IO1); also elsewhere on the board
/02_ESP32_S3_Core/I2C_EXT_SDA: U6.6 (IO2); also elsewhere on the board
/02_ESP32_S3_Core/IMU_INT1: U6.19 (IO15); also elsewhere on the board
/02_ESP32_S3_Core/SIM7080_DTR: U6.10 (IO6); also elsewhere on the board
/02_ESP32_S3_Core/SIM7080_PWRKEY_CTRL: U6.8 (IO4); also elsewhere on the board
/02_ESP32_S3_Core/SIM7080_RI: U6.11 (IO7); also elsewhere on the board
/02_ESP32_S3_Core/SIM7080_STATUS: U6.12 (IO8); also elsewhere on the board
/02_ESP32_S3_Core/SIM7080_TX_TO_ESP: U6.22 (IO18); also elsewhere on the board
/04_Sensors/I2C_SCL: U6.17 (IO13); also elsewhere on the board
/04_Sensors/I2C_SDA: U6.18 (IO14); also elsewhere on the board
BOOT: C10.1, R14.2, SW2.1, U6.4 (IO0)
EN: C9.1, R12.2, SW1.1, U6.45 (EN)
GND: C7.2, C8.2, C9.2, C10.2, D2.1 (K), SW1.2, SW2.2, TP16.1 (1_1), U6.1 (GND), U6.2 (GND), U6.42 (GND), U6.43 (GND), U6.46 (GND), U6.47 (GND), U6.48 (GND), U6.49 (GND), U6.50 (GND), U6.51 (GND), U6.52 (GND), U6.53 (GND), U6.54 (GND), U6.55 (GND), U6.56 (GND), U6.57 (GND), U6.58 (GND), U6.59 (GND), U6.60 (GND), U6.61 (GND), U6.62 (GND), U6.63 (GND), U6.64 (GND), U6.65 (GND); also elsewhere on the board
unnamed: D2.2 (A), R13.2
unnamed: TP12.1 (1_1), U6.34 (IO38)
unnamed: TP13.1 (1_1), U6.35 (IO39)
unnamed: TP14.1 (1_1), U6.36 (IO40)
STATUS_LED: R13.1, U6.30 (IO48)

Notes on the sheet:
PUll Up resistor on Sensor Sheet
BOOT Button
Reset & Boot Control
User Status LED
RST Button
ESP32-S3 Wireless Controller Core
ESP32-S3-MINI-1 Core
ESP32-S3 Core Design Notes - ESP32-S3-MINI-1-N8: Wi-Fi and Bluetooth LE. - Module supply: +3V3, with local decoupling. - USB D- / D+: GPIO19 / GPIO20. - EN and BOOT: reset and download-mode buttons. - Internal I2C: GPIO13 / GPIO14, fuel gauge and sensors. - External I2C: GPIO1 / GPIO2, separate sig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

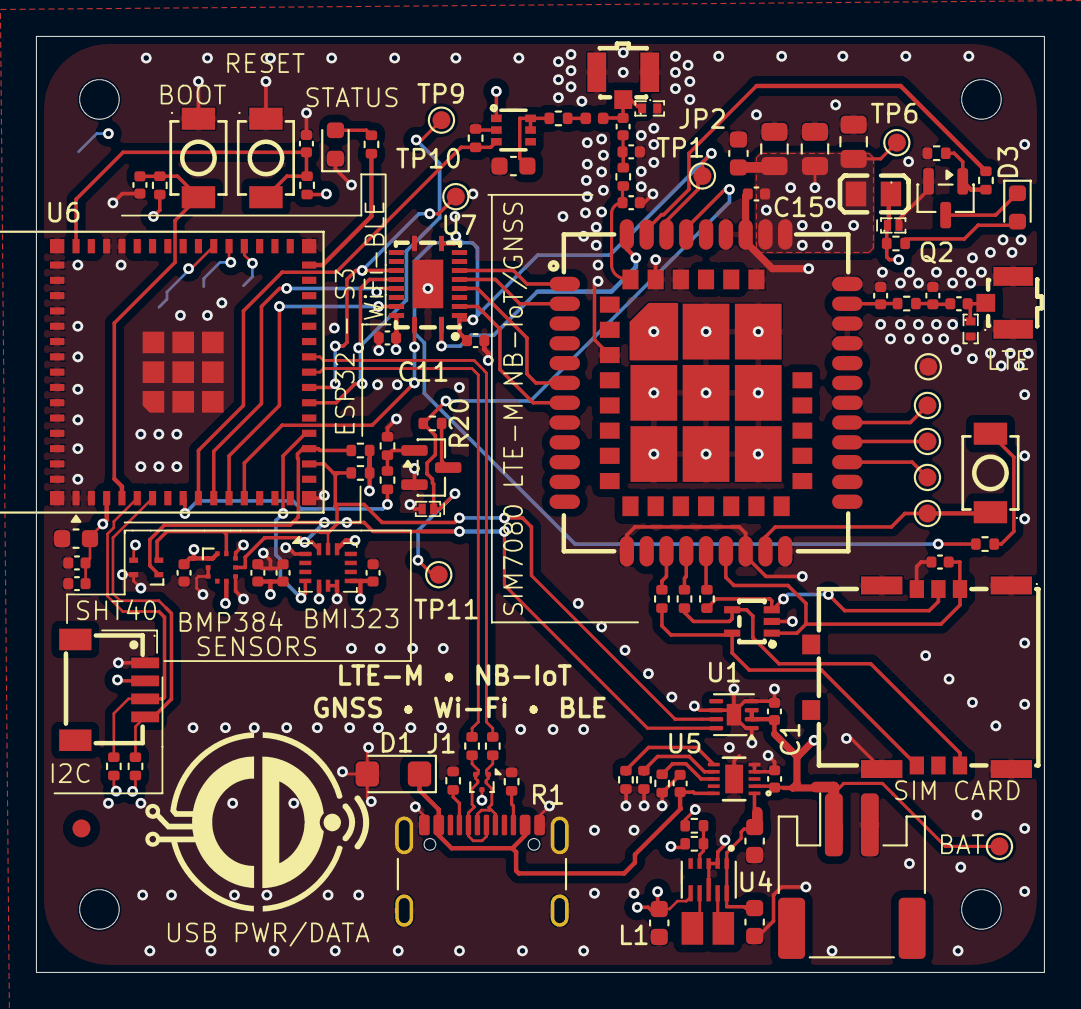
[picture p54: board EdgeLink_S3_Cellular.kicad_pcb from above]

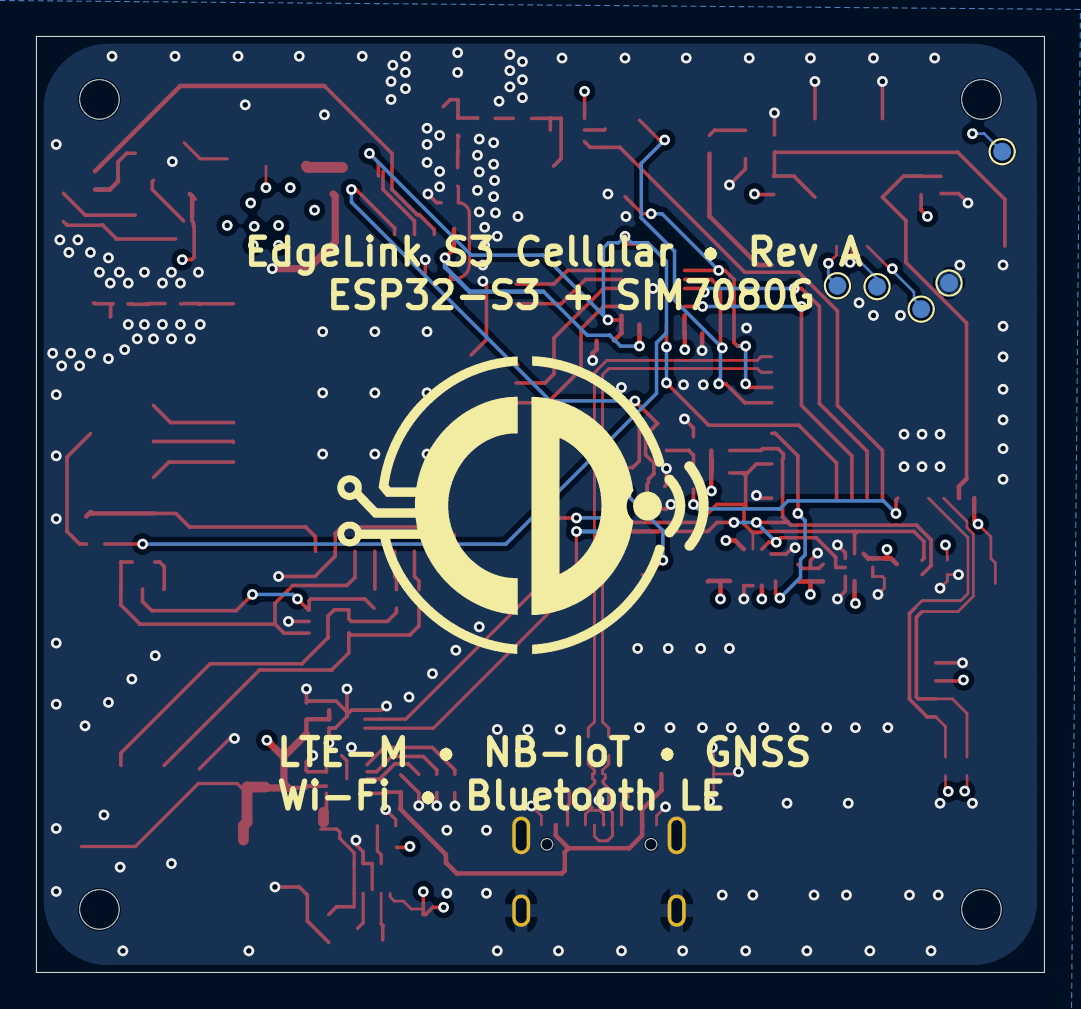
[picture p55: board EdgeLink_S3_Cellular.kicad_pcb from below]

Board: 4 copper layers, 56.0 x 52.0 mm, 109 parts (5 on the bottom side), 70 nets.
